ilkerya/Emulator_PCB/Cur_Emul_1.jpg

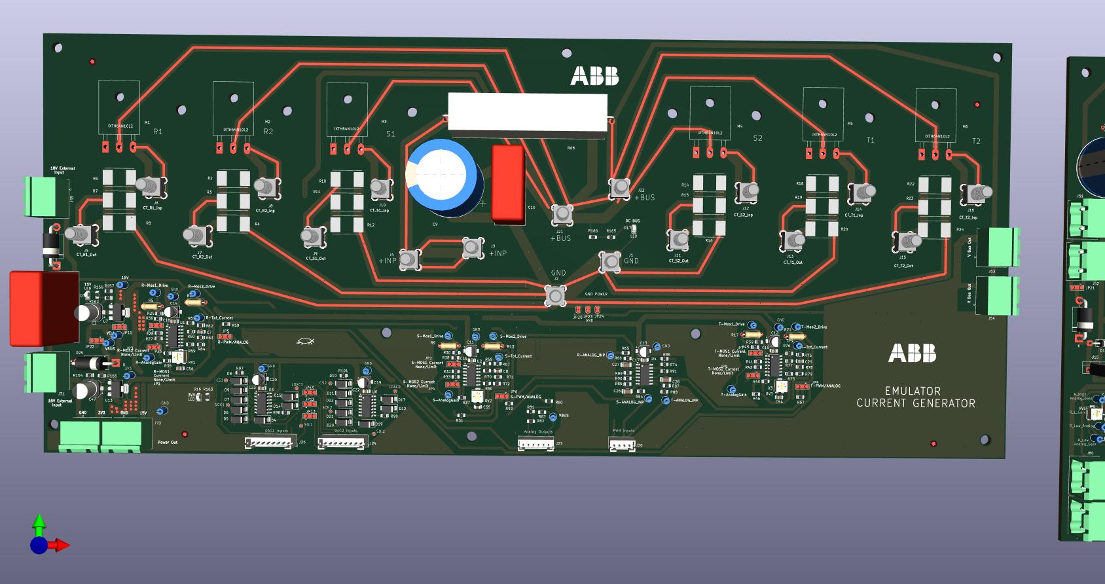
Cur_Emul_1.jpg
