ilkerya/Emulator_PCB/Cur_Emul_4.jpg

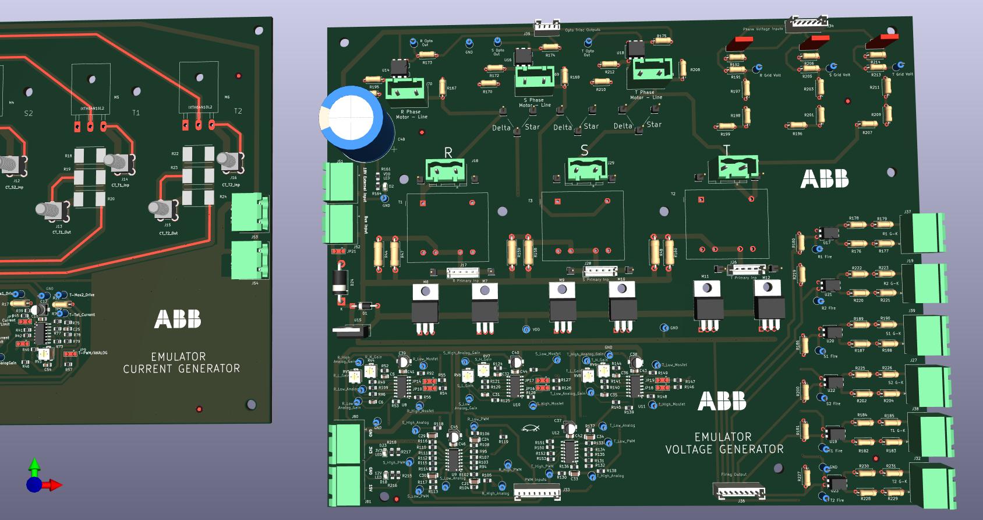
Cur_Emul_4.jpg
