ilkerya/Emulator_PCB/Cur_Emul/GERBER/Cur_Emul_3.jpg

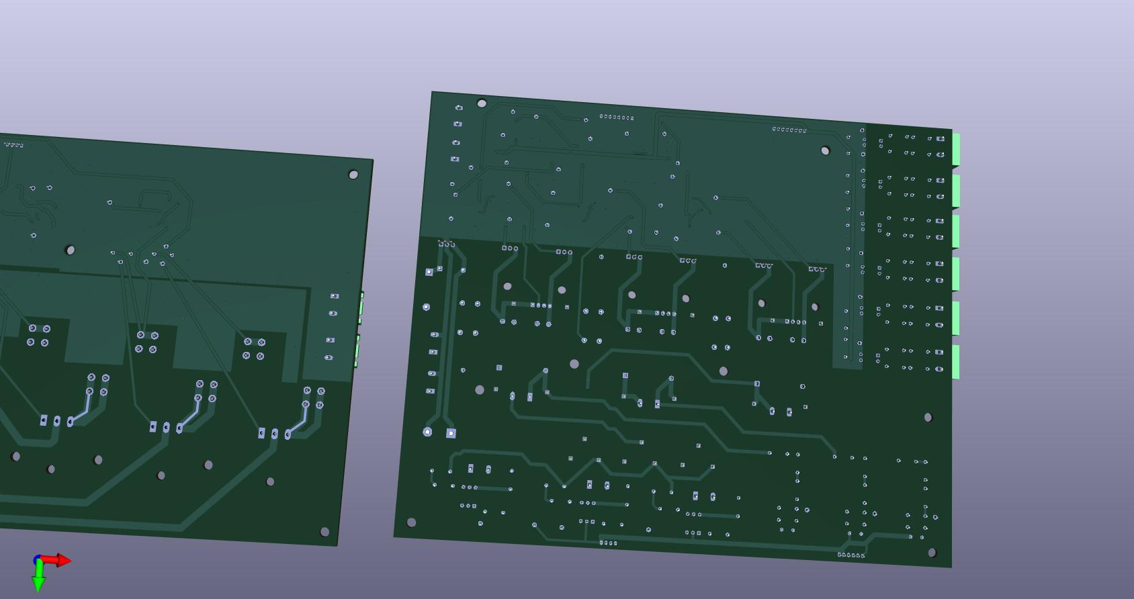
Cur_Emul/GERBER/Cur_Emul_3.jpg
