ilkerya/Emulator_PCB/Cur_Emul/GERBER/Cur_Emul_5.jpg

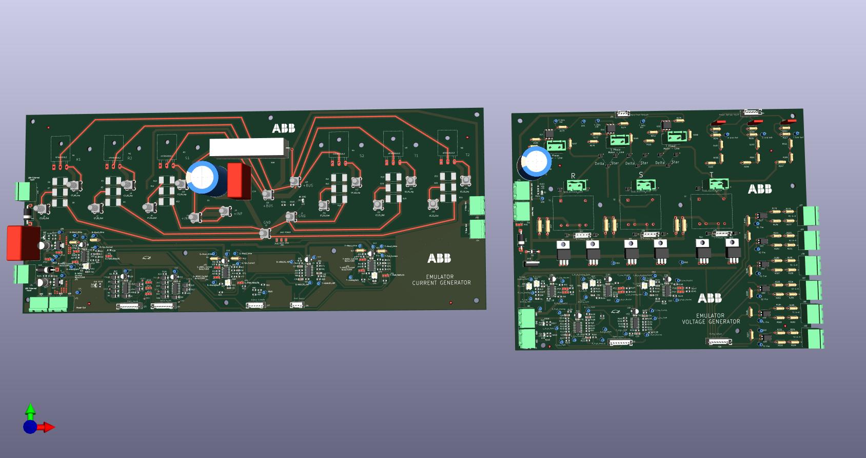
Cur_Emul/GERBER/Cur_Emul_5.jpg
