ilkerya/Emulator_PCB/Cur_Emul/GERBER/Cur_Emul__2.jpg

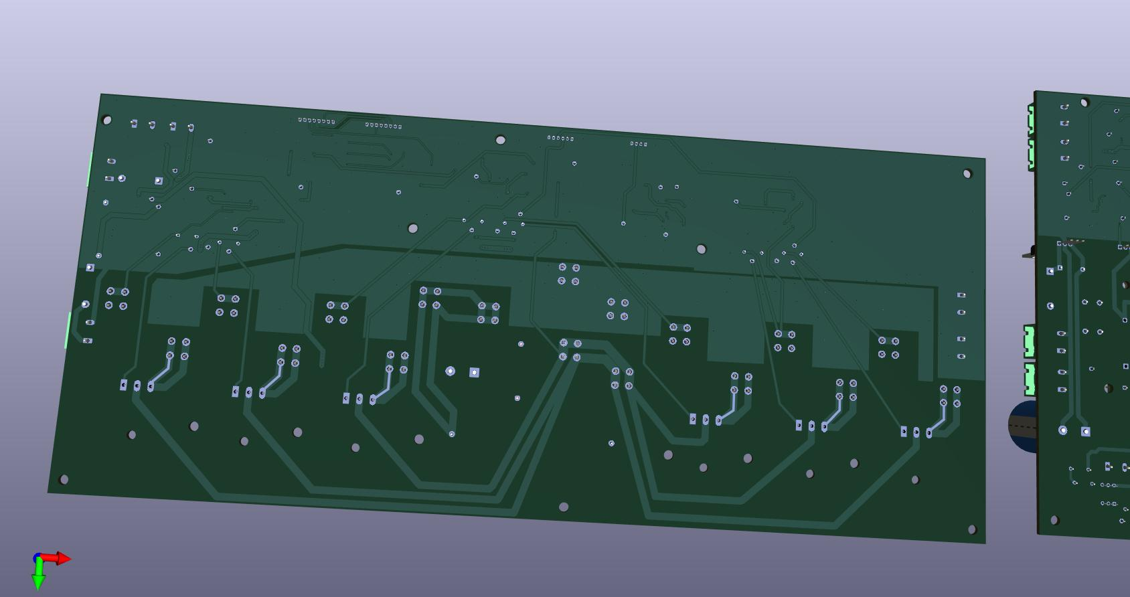
Cur_Emul/GERBER/Cur_Emul__2.jpg
