ilkerya/Emulator_PCB/SoftStart_Connection.jpg

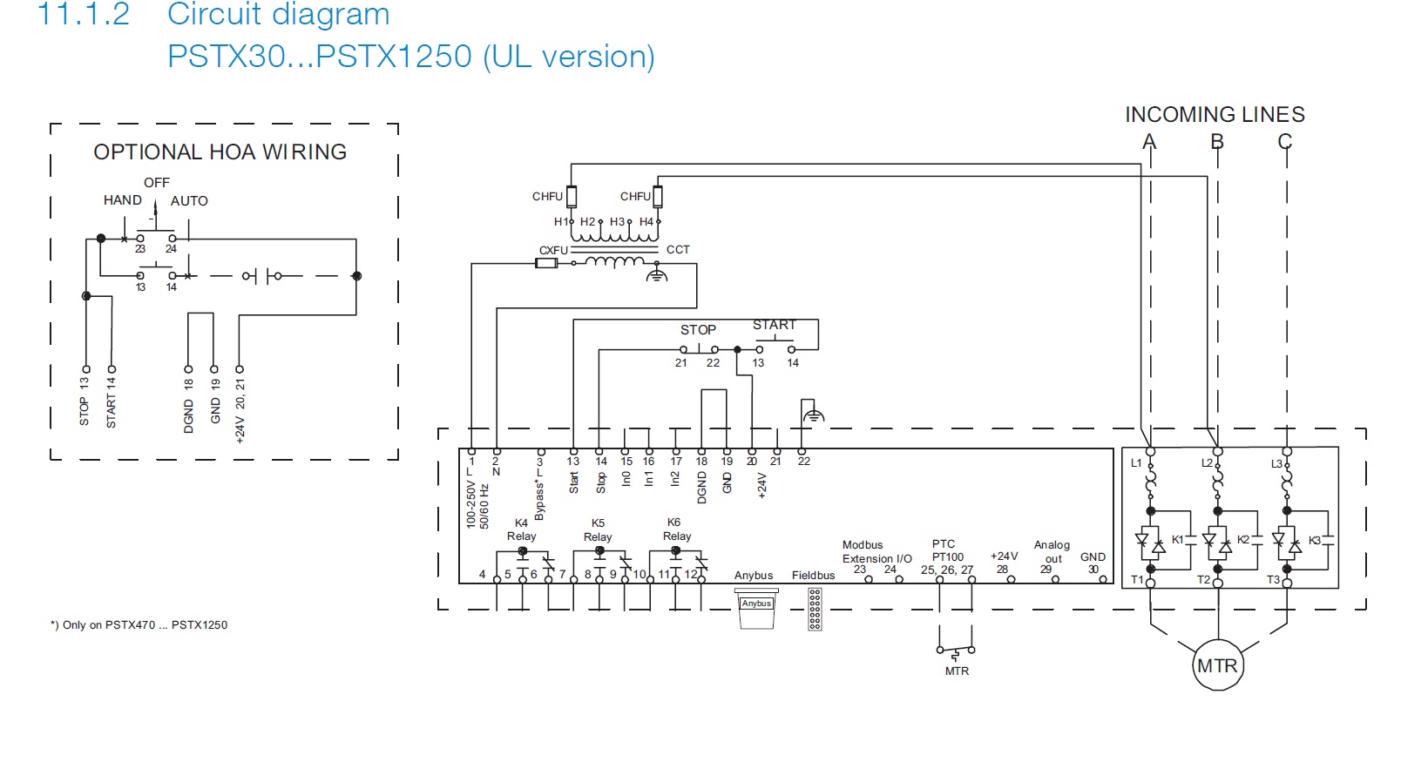
SoftStart_Connection.jpg
