ilkerya/Emulator_PCB/Cur_Emul/Emulator_BOM_V2.xlsx

Sheet: Readme
1 | Check next sheets for the details indicvated as red color
2 | All resistors %5 toleranace unless indicated as %1
3 | All axial tht resistors 0.25W toleranace unless indicated
4 | Do Not Mount ! | Purchase the components, do nat assemble just send with the PCB's
5 | Do Not Buy ! | Neither purchase nor assembly
 | Required Samples
 | At least 15 PCB (2x15)
 | Assembled Samples
 | 10 Samples with full SMD components assembled
 | just 2 samples with the THT components assembled (8 samples with just SMD)

Sheet: Full_BOM
Id | Designator | Footprint | Quantity | Designation | Supplier and ref
1 | U3,U10,U11,U4,U12,U9,U1,U2,U8 | SOIC-14_3.9x8.7mm_P1.27mm | 9 | Opamp_Quad_OPA_4196
2 | R95,R115,R97,R71,R116,R80,R81,R99,R63,R74,R133,R132,R64,R94,R61,R136,R65,R102,R79,R153,R111,R107,R104,R130,R103,R106,R76,R108,R137,R110,R134,R87,R117,R86,R98,R131,R78,R101,R113,R69,R72,R84,R151,R152,R112,R85,R150,R135,R66,R88,R114 | R_0805_2012Metric_Pad1.20x1.40mm_HandSolder | 51 | 10K %1
3 | R204,R231,R178,R228,R221,R222,R183,R226,R188,R190,R225,R189,R182,R179,R202,R229,R177,R220,R185,R176,R230,R187,R223,R184 | R_Axial_DIN0207_L6.3mm_D2.5mm_P7.62mm_Horizontal | 24 | 33K
4 | J60,J65,J40,J42,J64,J59,J41,J67,J56,J62,J61,J48,J45,J63,J46,J66,J47,J43,J57,J58,J44 | PinHeader_1x01_P2.54mm_Vertical | 21 | PinHeader_1x2.54mm
5 | J80,J31,J73,J51,J38,J27,J72,J81,J39,J53,J32,J37,J19,J52,J55,J54 | PhoenixContact_GMSTBA_2,5_2-G_1x02_P7.50mm_Horizontal | 16 | 2x7.50mm_Horizontal_PhoenixContact_GMSTBA
6 | D26,D25,D24 | D_DO-201AD_P15.24mm_Horizontal | 3 | 1N5407
7 | R28,R144,R32,R39,R52,R129,R41,R56,R138,R148,R109,R125,R118,R119,R27,R145,R105,R31,R30,R25,R149,R139,R53,R128,R33,R92,R42,R40,R124,R26 | R_0805_2012Metric_Pad1.20x1.40mm_HandSolder | 30 | 100R %1
8 | C14,C45,C13,C20,C37,C11,C40,C38,C39,C12,C19 | CP_Elec_4x3.9 | 11 | 10uF/50V
9 | J22,J15,J14,J10,J13,J9,J2,J4,J16,J7,J8,J5,J11,J6,J3,J21,J1,J12 | Wuerth_REDCUBE-THR_WP-THRSH_74651175_THR | 18 | Wuerth_REDCUBE-74651175_ScrewTerminal
10 | C42,C5,C23,C54,C6,C44,C55,C32,C36,C31,C16,C46,C22,C17,C18,C35,C56,C7,C15,C25,C8,C41,C43 | C_0805_2012Metric_Pad1.18x1.45mm_HandSolder | 23 | 10nF/50V
11 | M4,M1,M2,M5,M3,M6 | TO-247-3_Horizontal_TabDown | 6 | IXTH64N10L2 |  |  | Do Not Mount !
12 | U5,U6 | SOIC-14_3.9x8.7mm_P1.27mm | 2 | MCP4922-ESL
13 | R163,R216,R91,R161,R218,R90,R164,R215,R217,R166,R89,R165 | R_0805_2012Metric_Pad1.20x1.40mm_HandSolder | 12 | 5K %1
14 | RV2,RV5,RV6,RV1,RV7,RV8,RV3,RV9,RV4 | Potentiometer_Bourns_3314J_Vertical | 9 | 10K_SMD_Pot
15 | TP37,TP34,TP63,TP66,TP5,TP42,TP33,TP13,TP67,TP58,TP76,TP18,TP32,TP51,TP45,TP41,TP56,TP14,TP48,TP1,TP52,TP69,TP77,TP75,TP71,TP28,TP2,TP38,TP3,TP35,TP68,TP10,TP43,TP61,TP17,TP72,TP11,TP55,TP64,TP31,TP74,TP15,TP20,TP6,TP57,TP27,TP70,TP59,TP8,TP7,TP12,TP78,TP50,TP65,TP49,TP4,TP47,TP19,TP16,TP29,TP44,TP46,TP9,TP62,TP60,TP30,TP73,TP36,TP53,TP54 | TestPoint_Loop_D1.80mm_Drill1.0mm_Beaded | 70 | Test_Point_THT_KeyStone
16 | R77,R49,R73,R121,R120,R59,R60,R140,R141,R50,R70,R96 | R_0805_2012Metric_Pad1.20x1.40mm_HandSolder | 12 | 3K3 %1
17 | U22,U21,U23,U19,U20,U17 | DIP-4_W7.62mm | 6 | SFH620A-2
18 | C26,C29,C24,C27,C30,C34,C33,C28,C21 | C_1206_3216Metric_Pad1.33x1.80mm_HandSolder | 9 | 1uF/50V
19 | R197,R201,R196,R211,R203,R207,R198,R199,R209 | R_Axial_DIN0207_L6.3mm_D2.5mm_P7.62mm_Horizontal | 9 | 470K
20 | D8,D10,D4,D6,D15,D20,D7,D22,D5,D13,D19,D14,D9,D21,D12,D11 | D_SMA | 16 | US2AA
21 | J68,J70,J29,J69,J30,J18 | PhoenixContact_GMSTBVA_2,5_2-G_1x02_P7.50mm_Vertical | 6 | 2x7.50mm_Vertical_PhoenixContact_GMSTB
22 | R17,R13,R1,R5,R9,R21 | R_Axial_DIN0207_L6.3mm_D2.5mm_P7.62mm_Horizontal | 6 | 330K
23 | R192,R206,R173,R174,R175,R214 | R_Axial_DIN0207_L6.3mm_D2.5mm_P7.62mm_Horizontal | 6 | 1K
24 | R35,R146,R127,R46,R37,R126,R54,R38,R55,R45,R36,R147 | R_0805_2012Metric_Pad1.20x1.40mm_HandSolder | 12 | 10R
25 | R57,R162,R62,R75,R82,R93,R58,R67,R83 | R_0805_2012Metric_Pad1.20x1.40mm_HandSolder | 9 | 1K %1
26 | R169,R208,R167 | R_Axial_DIN0207_L6.3mm_D2.5mm_P7.62mm_Horizontal | 3 | 100R
27 | D1 | D_DO-41_SOD81_P10.16mm_Horizontal | 1 | 1N4007
28 | R210,R212,R172,R195,R168,R170 | R_Axial_DIN0207_L6.3mm_D2.5mm_P7.62mm_Horizontal | 6 | 100K
29 | TP23,TP40,TP24,TP39,TP21,TP26,TP22,TP25 | TestPoint_Pad_D1.0mm | 8 | Test_Pad_Not_A_Component
30 | M7,M10,M12,M9,M8,M11 | TO-220-3_Horizontal_TabDown | 6 | IRF530 |  | Do Not Mount !
31 | R157 | R_0805_2012Metric_Pad1.20x1.40mm_HandSolder | 1 | 750R / %1
32 | D23,D17,D3,D16,D2,D18 | LED_0805_2012Metric_Pad1.15x1.40mm_HandSolder | 6 | LED
33 | R11,R19,R18,R10,R2,R7,R3,R23,R12,R20,R14,R24,R15,R4,R22,R6,R16,R8 | R_Shunt_Vishay_WSR2_WSR3 | 18 | 10mOhm_Vishay_WSR3_Shunt |  | Do Not Mount !
34 | R200,R181,R219,R205,R180,R186,R227,R191,R213 | R_Axial_DIN0207_L6.3mm_D2.5mm_P7.62mm_Horizontal | 9 | 10K
35 | U13,U7 | SOT-223-3_TabPin2 | 2 | LM317_SOT-223
36 | C10,C49 | C_Rect_L28.0mm_W12.0mm_P22.50mm_MKS4 | 2 | 1uF/50V MKT |  | Do Not Mount ! |  | Do Not Buy !
37 | U14,U16,U18 | DIP-6_W7.62mm | 3 | MOC3023M
38 | J36,J25,J24,J33 | JST_PH_B8B-PH-K_1x08_P2.00mm_Vertical | 4 | Conn_01x08_Pin_JST_2.0mm
39 | R154 | R_0805_2012Metric_Pad1.20x1.40mm_HandSolder | 1 | 1K22 / %1
40 | R155 | R_0805_2012Metric_Pad1.20x1.40mm_HandSolder | 1 | 110R / %1
41 | J35,J20 | JST_PH_B4B-PH-K_1x04_P2.00mm_Vertical | 2 | Conn_01x04_Pin_JST_2.0mm
42 | C50,C52,C51 | C_Rect_L7.0mm_W2.0mm_P5.00mm | 3 | 100nF/50V
43 | J34,J23 | JST_PH_B6B-PH-K_1x06_P2.00mm_Vertical | 2 | Conn_01x06_Pin_JST_2.0mm
44 | T1,T3,T2 | Transformer_Myrra_EI30-5_44000_Horizontal | 3 | Transformer_1P_2S |  | Do Not Mount !
45 | R158,R44,R160,R48,R47,R159 | R_Axial_DIN0411_L9.9mm_D3.6mm_P12.70mm_Horizontal | 6 | 4R7/2W
46 | J17,J26,J28 | JST_EH_B4B-EH-A_1x04_P2.50mm_Vertical | 3 | Conn_01x04_Pin_JST_2.5mm
47 | U15 | TO-220-3_Vertical | 1 | LM7812_TO220
48 | C9 | CP_Radial_D26.0mm_P10.00mm_SnapIn | 1 | 300uF/50V |  | Do Not Mount ! |  | Do Not Buy !
49 | C48 | CP_Radial_D24.0mm_P10.00mm_SnapIn | 1 | 1000uF/50V |  | Do Not Mount ! |  | Do Not Buy !
50 | R156 | R_0805_2012Metric_Pad1.20x1.40mm_HandSolder | 1 | 450R / %1
51 | C47,C3 | CP_Elec_6.3x7.7 | 2 | 100uF/50V
52 | R68 | R_Axial_Power_L60.0mm_W14.0mm_P66.04mm | 1 | 1R/100W |  | Do Not Mount ! |  | Do Not Buy !

Sheet: Actives
 |  | Package | Count | Part No | Purchase Info
1 | U22,U21,U23,U19,U20,U17 | DIP-4_W7.62mm | 6 | SFH620A-2 | sfh620a.pdf (https://www.vishay.com/docs/83675/sfh620a.pdf)
2 | U5,U6 | SOIC-14_3.9x8.7mm_P1.27mm | 2 | MCP4922-ESL | MCP4922-ESL (https://www.digikey.se/sv/products/detail/microchip-technology/MCP4922-E-SL/716258)
3 | U3,U10,U11,U4,U12,U9,U1,U2,U8 | SOIC-14_3.9x8.7mm_P1.27mm | 9 | OPA4196 | 4196 (https://www.digikey.se/en/products/detail/texas-instruments/OPA4196IDR/7604402)
4 | U13,U7 | SOT-223-3_TabPin2 | 2 | LM317 | LM317MDCYR (https://www.digikey.se/en/products/detail/texas-instruments/LM317MDCYR/454187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)
5 | U14,U16,U18 | DIP-6_W7.62mm | 3 | MOC3023M | MOC3023M (https://www.digikey.se/sv/products/detail/onsemi/MOC3023M/284886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)
6 | U15 | TO-220-3_Vertical | 1 | LM7812
7 | M4,M1,M2,M5,M3,M6 | TO-247-3_Horizontal_TabDown | 6 | IXTH64N10L2 | IXTH64N10L2 IXYS | Discrete Semiconductor Products | DigiKey (https://www.digikey.se/en/products/detail/ixys/IXTH64N10L2/5810059) |  | Do Not Mount
8 | M7,M10,M12,M9,M8,M11 | TO-220-3_Horizontal_TabDown | 6 | IRF530 | IRF530PBF Vishay Siliconix | Diskreta halvledarprodukter | DigiKey (https://www.digikey.se/sv/products/detail/vishay-siliconix/IRF530PBF/811781) |  | Do Not Mount
9 | D23,D17,D3,D16,D2,D18 | LED_0805_2012Metric_Pad1.15x1.40mm_HandSolder | 6 | Green LED
10 | D26,D25,D24 | D_DO-201AD_P15.24mm_Horizontal | 3 | 1N5407 | 1n5400.pdf (https://www.vishay.com/docs/88516/1n5400.pdf)
11 | D8,D10,D4,D6,D15,D20,D7,D22,D5,D13,D19,D14,D9,D21,D12,D11 | D_SMA | 16 | US2AA | US2AA (https://www.onsemi.com/pdf/datasheet/us2aa-d.pdf) | US2MA onsemi | Discrete Semiconductor Products | DigiKey (https://www.digikey.se/en/products/detail/onsemi/US2MA/5844490?msockid=3cb83edbc5ab62f42d3f2b92c4fc63d6)
12 | D1 | D_DO-41_SOD81_P10.16mm_Horizontal | 1 | 1N4007

Sheet: Connector_Pin
 | ON PCB |  | Count per PCB pair |  |  |  |  |  | Item Number
 | 7.5 mm Pitch Connectors form Phoenix Contact |  |  |  |  |  |  | Purchase | Phoenix Contact
1 | J70,J69,J68,J29,J30,J18 | PhoenixContact_GMSTBVA_2,5_2-G_1x02_P7.50mm_Vertical | 6 | Conn_01x02_Pin |  | Vertical | Female | 1. Priority (https://www.mouser.se/ProductDetail/Phoenix-Contact/1766660?qs=VKrXD49J9ErTDZSltEsgTQ%3D%3D) | 1766660
 |  |  |  |  |  |  |  | 2.Priority (https://www.mouser.se/ProductDetail/Phoenix-Contact/1766453?qs=s6DiDDoRpTbteEwY3ZEIDg%3D%3D) | 1766453
2 | J31,J51,J38,J27,J39,J53,J32,J37,J19,J52,J55,J54 | PhoenixContact_GMSTBA_2,5_2-G_1x02_P7.50mm_Horizontal | 16 | Conn_01x02_Pin |  | Horizontal | Female | 1.Priority (https://www.digikey.se/en/products/detail/phoenix-contact/1766343/348818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) | 1766343
 | J72,J73,J80,J81 |  |  |  |  |  |  | 2.Priority (https://www.mouser.se/ProductDetail/Phoenix-Contact/1766013?qs=s6DiDDoRpTZAMqnWKfx7Zg%3D%3D) | 1766013
 | High Current Terminals from Wurth
3 | J22,J15,J14,J10,J13,J9,J2,J4,J16,J7,J8,J5,J11,J6,J3,J21,J1,J12 | Wuerth_REDCUBE-THR_WP-THRSH_74651175_THR | 18 | Screw_Terminal_01x01 |  |  | 74651175R (https://www.digikey.co.uk/en/products/detail/w%C3%BCrth-elektronik/74651175R/6644002) | 74651175 Datasheet WP-THRSH REDCUBE (https://www.we-online.com/components/products/datasheet/74651175.pdf)
 | Test Pins
4 | TP37,TP34,TP63,TP66,TP5,TP42,TP33,TP13,TP67,TP58,TP76,TP18,TP32,TP51,TP45,TP41,TP56,TP14,TP48,TP1,TP52,TP69,TP77,TP75,TP71,TP28,TP2,TP38,TP3,TP35,TP68,TP10,TP43,TP61,TP17,TP72,TP11,TP55,TP64,TP31,TP74,TP15,TP20,TP6,TP57,TP27,TP70,TP59,TP8,TP7,TP12,TP78,TP50,TP65,TP49,TP4,TP47,TP19,TP16,TP29,TP44,TP46,TP9,TP62,TP60,TP30,TP73,TP36,TP53,TP54 | TestPoint_Loop_D1.80mm_Drill1.0mm_Beaded | 70 | TestPoint_Alt |  |  | 5117 Keystone Electronics | Test and Measurement | DigiKey (https://www.digikey.se/en/products/detail/keystone-electronics/5117/2170320)
 | Pin terminals Do Not Mount!
5 | J60,J65,J40,J42,J64,J59,J41,J67,J56,J62,J61,J48,J45,J63,J46,J66,J47,J43,J57,J58,J46 | PinHeader_1x01_P2.54mm_Vertical | 23 | Conn_01x01_Pin |  |  | 61300411121 Würth Elektronik | Kontaktdon | DigiKey (https://www.digikey.se/sv/products/detail/w-rth-elektronik/61300411121/4846827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)
 | 2.00 - 2.5 mm pitch Signal Connectors JST |  |  |  |  | RS
6 | J36,J25,J24,J33 | JST_PH_B8B-PH-K_1x08_P2.00mm_Vertical | 4 | Conn_01x08_Pin |  |  | 5128658P (https://se.rs-online.com/web/p/pcb-headers/5128658P)
7 | J35,J20 | JST_PH_B4B-PH-K_1x04_P2.00mm_Vertical | 2 | Conn_01x04_Pin |  |  | 1724893 (https://se.rs-online.com/web/p/pcb-headers/1724893)
8 | J34,J23 | JST_PH_B6B-PH-K_1x06_P2.00mm_Vertical | 2 | Conn_01x06_Pin |  |  | 1724942 (https://se.rs-online.com/web/p/pcb-headers/1724942)
9 | J17,J26,J28 | JST_EH_B4B-EH-A_1x04_P2.50mm_Vertical | 3 | Conn_01x04_Pin |  |  | 5151406 (https://se.rs-online.com/web/p/pcb-headers/5151406)
 | MATING Cable Side Not to be Mounted !
10 | Housing - Cable Part Mating for Phoenix Contact |  | 22 | 1766880 (https://eu.mouser.com/ProductDetail/Phoenix-Contact/1766013?qs=s6DiDDoRpTZAMqnWKfx7Zg%3D%3D) | 1766880
 | HOUSING -non PCB -Mating for JST for 2.00 - 2.50 mm Connectors |  | 25 | https://eu.mouser.com/ProductDetail/Phoenix-Contact/1766880?qs=CXo1rOUe%2FWv6HeuUWYkLcg%3D%3D
11 | 2mm 4 row |  | 2 | https://se.rs-online.com/web/p/wire-housings-plugs/4766782
12 | 2mm 6 row |  | 2 | https://se.rs-online.com/web/p/wire-housings-plugs/4766805P
13 | 2mm 8 row |  | 4 | https://se.rs-online.com/web/p/wire-housings-plugs/4766827
14 | 2,5 mm 4 row |  | 3 | https://se.rs-online.com/web/p/wire-housings-plugs/3116221

Sheet: Transformer&Other
 |  |  | Count
47 | T1,T3,T2 | Transformer_Myrra_EI30-5_44000_Horizontal | 3 | Transformer_1P_2S | Do Not Mount! | Transformer | BV EI 304 2047 | Hahn PCB-transformator, 230 VAC, 2x 12 VAC, 108mA, 2.6VA | Elfa Distrelec Sverige (https://www.elfa.se/sv/pcb-transformator-230-vac-2x-12-vac-108ma-6va-hahn-bv-ei-304-2047/p/30294632?pos=5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)
34 | R11,R19,R18,R10,R2,R7,R3,R23,R12,R20,R14,R24,R15,R4,R22,R6,R16,R8 | R_Shunt_Vishay_WSR2_WSR3 | 18 | 10mR | Do Not Mount! | Shunt Resistor | WSR3R0100FEA Vishay Dale | Resistors | DigiKey (https://www.digikey.se/en/products/detail/vishay-dale/WSR3R0100FEA/712630)
15 | RV2,RV5,RV6,RV1,RV7,RV8,RV3,RV9,RV4 | Potentiometer_Bourns_3314J_Vertical | 9 | 10K |  | SMD Potentiometer | 3314J-1-103E Bourns Inc. | Potentiometers, Variable Resistors | DigiKey (https://www.digikey.se/en/products/detail/bourns-inc/3314J-1-103E/86580)
