ilkerya/Emulator_PCB/Cur_Emul/Cur_Emul.step

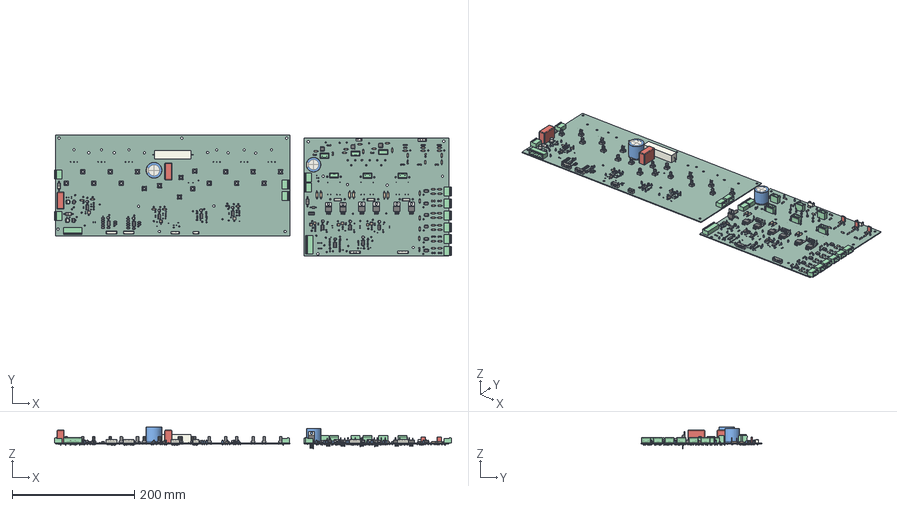
[picture p7: CAD file, 2025-10-06]
Cur_Emul/Cur_Emul.step
650.7 x 199.1 x 35.8 mm
R_0805_2012Metric x 130
R_Axial_DIN0207_L6.3mm_D2.5mm_P7.62mm_Horizontal x 63
PinHeader_1x01_P2.54mm_Vertical x 21
D_DO-201AD_P15.24mm_Horizontal x 3
CP_Elec_4x3.9 x 11
PhoenixContact_GMSTBA_2,5_2-G_1x02_P7.50mm_Horizontal x 12
Wuerth_REDCUBE-THR_WP-THRSH_74651175_THR x 18
C_0805_2012Metric x 23
SOIC-14_3.9x8.7mm_P1.27mm x 11
Potentiometer_Bourns_3314J_Vertical x 9
TestPoint_Loop_D1.80mm_Drill1.0mm_Beaded x 70
DIP-4_W7.62mm x 6
C_1206_3216Metric x 9
D_SMA x 16
PhoenixContact_GMSTBVA_2,5_2-G_1x02_P7.50mm_Vertical x 6
D_DO-41_SOD81_P10.16mm_Horizontal
TO-220-3_Horizontal_TabDown x 6
LED_0805_2012Metric x 6
PhoenixContact_GMSTBA_2,5_4-G-7,62_1x04_P7.62mm_Horizontal x 2
SOT-223 x 2
C_Rect_L28.0mm_W12.0mm_P22.50mm_MKS4 x 2
DIP-6_W7.62mm x 3
JST_PH_B8B-PH-K_1x08_P2.00mm_Vertical x 4
JST_PH_B4B-PH-K_1x04_P2.00mm_Vertical x 2
C_Rect_L7.0mm_W2.0mm_P5.00mm x 3
JST_PH_B6B-PH-K_1x06_P2.00mm_Vertical x 2
R_Axial_DIN0411_L9.9mm_D3.6mm_P12.70mm_Horizontal x 6
JST_EH_B4B-EH-A_1x04_P2.50mm_Vertical x 3
TO-220-3_Vertical
CP_Radial_D26.0mm_P10.00mm_SnapIn
CP_Radial_D24.0mm_P10.00mm_SnapIn
CP_Elec_6.3x7.7 x 2
R_Axial_Power_L60.0mm_W14.0mm_P66.04mm
Cur_Emul_PCB_1
Cur_Emul_PCB_2
