ilkerya/Emulator_PCB/Cur_Emul.pdf

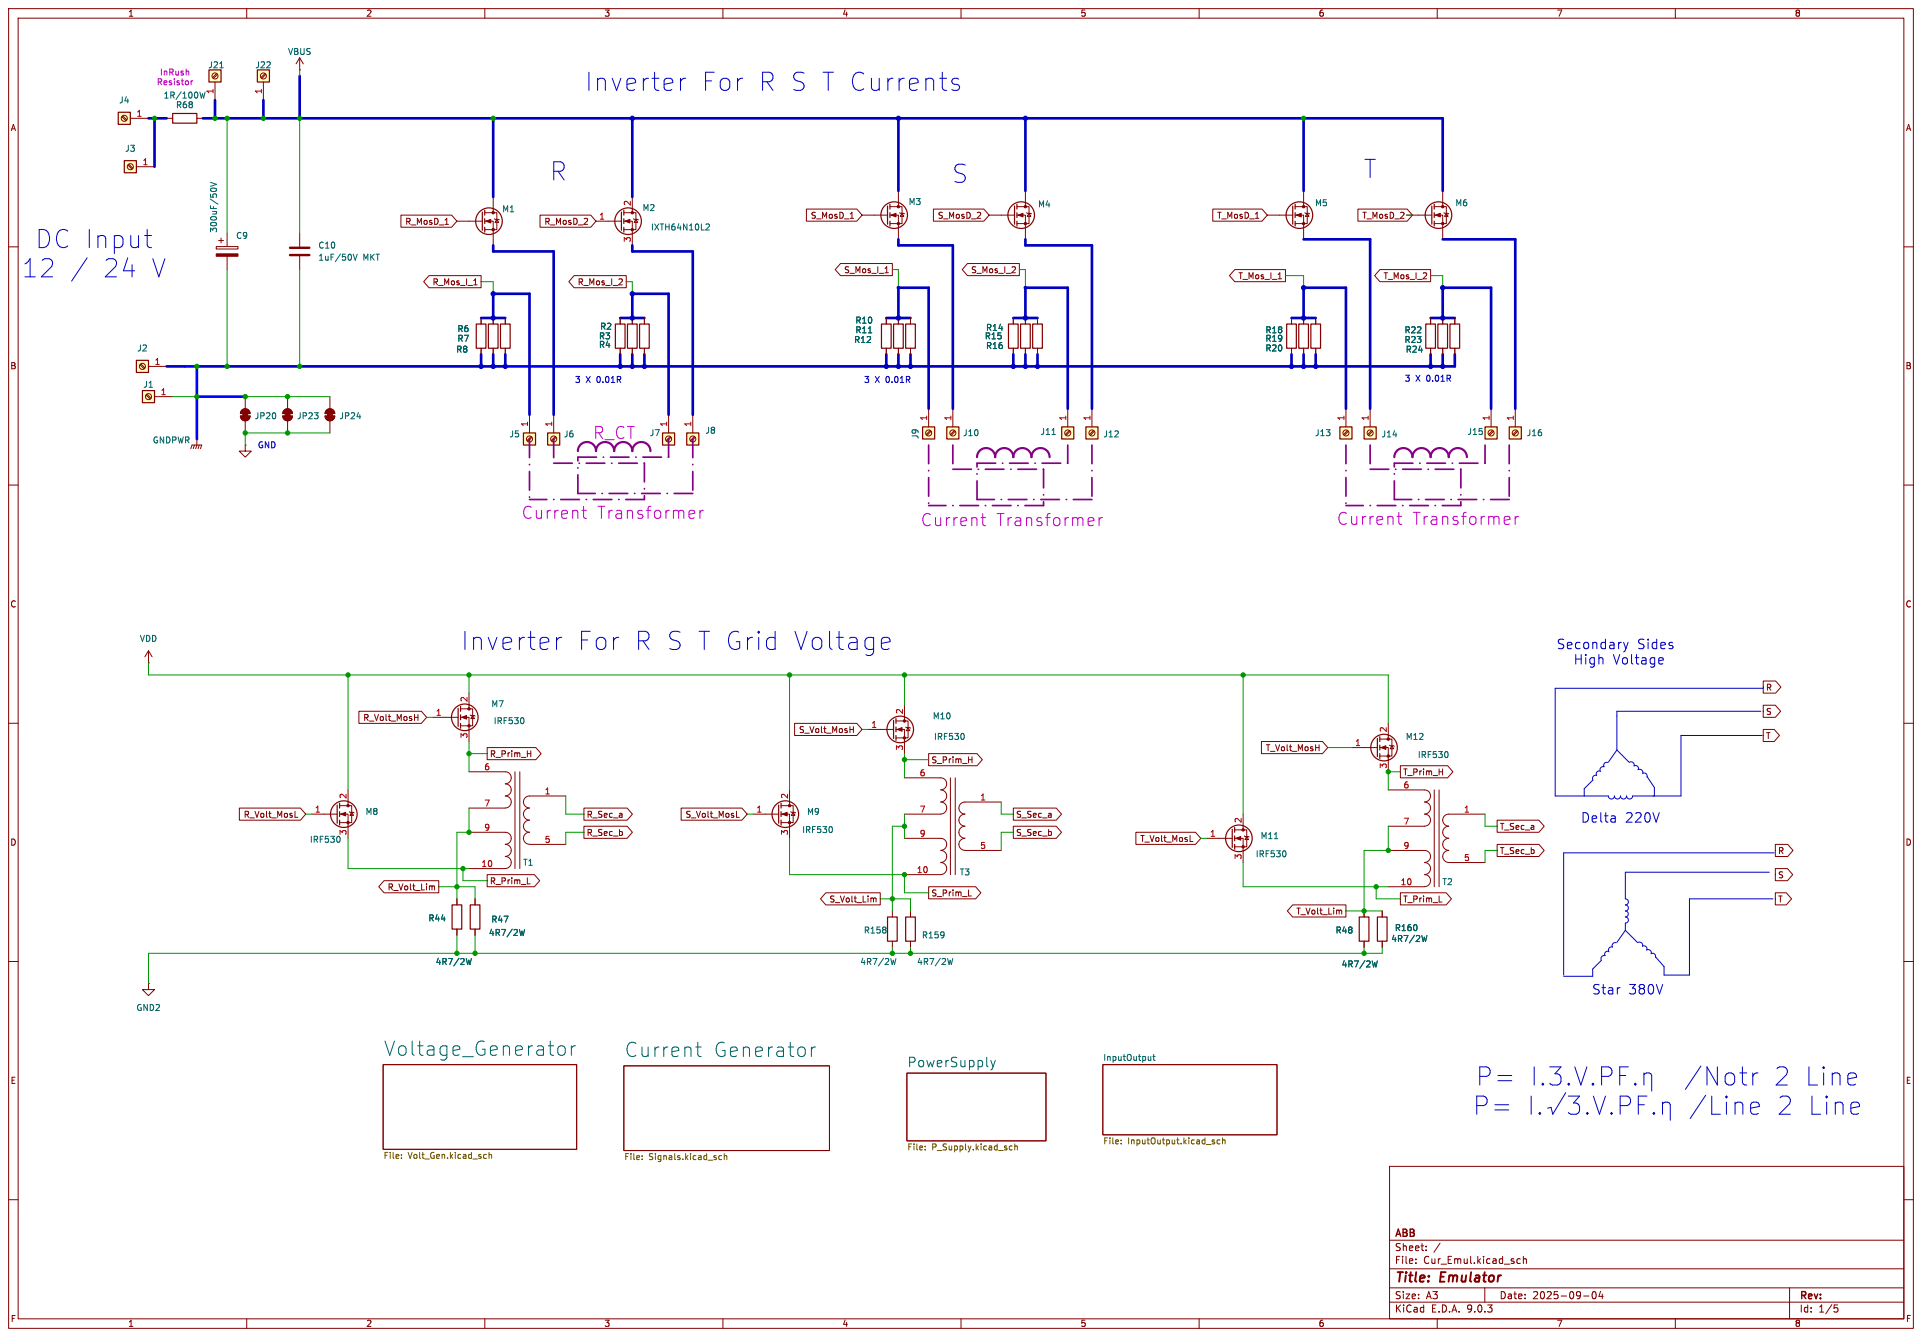
[picture p8: page 1]

Id: 1/5 Title: Emulator File: Cur_Emul.kicad_sch Sheet: / ABB PowerSupply

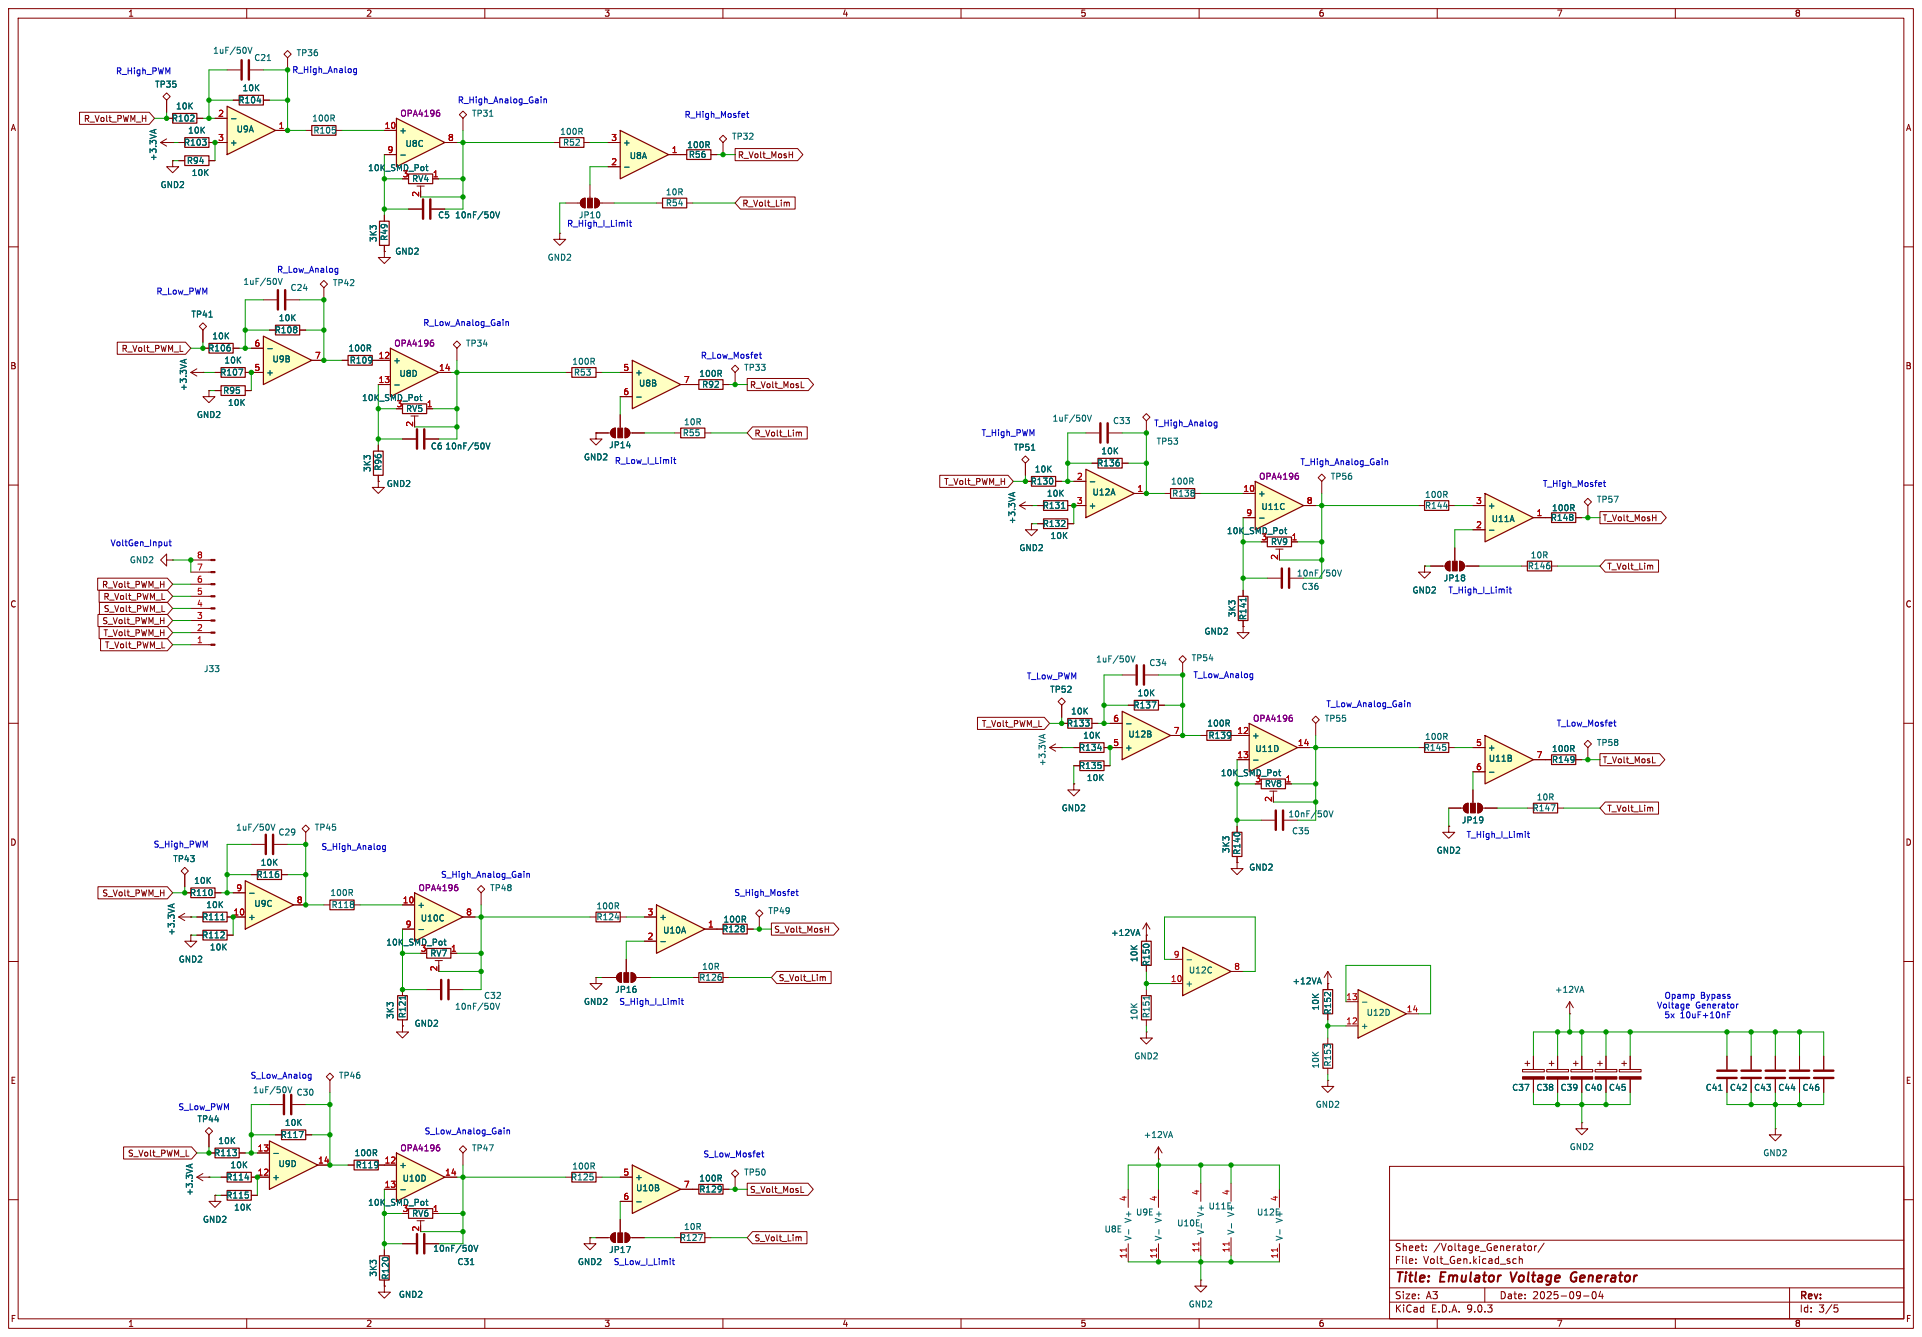
[picture p9: page 2]

Id: 3/5 Title: Emulator Voltage Generator File: Volt_Gen.kicad_sch Sheet: /Voltage_Generator/ +3.3VA

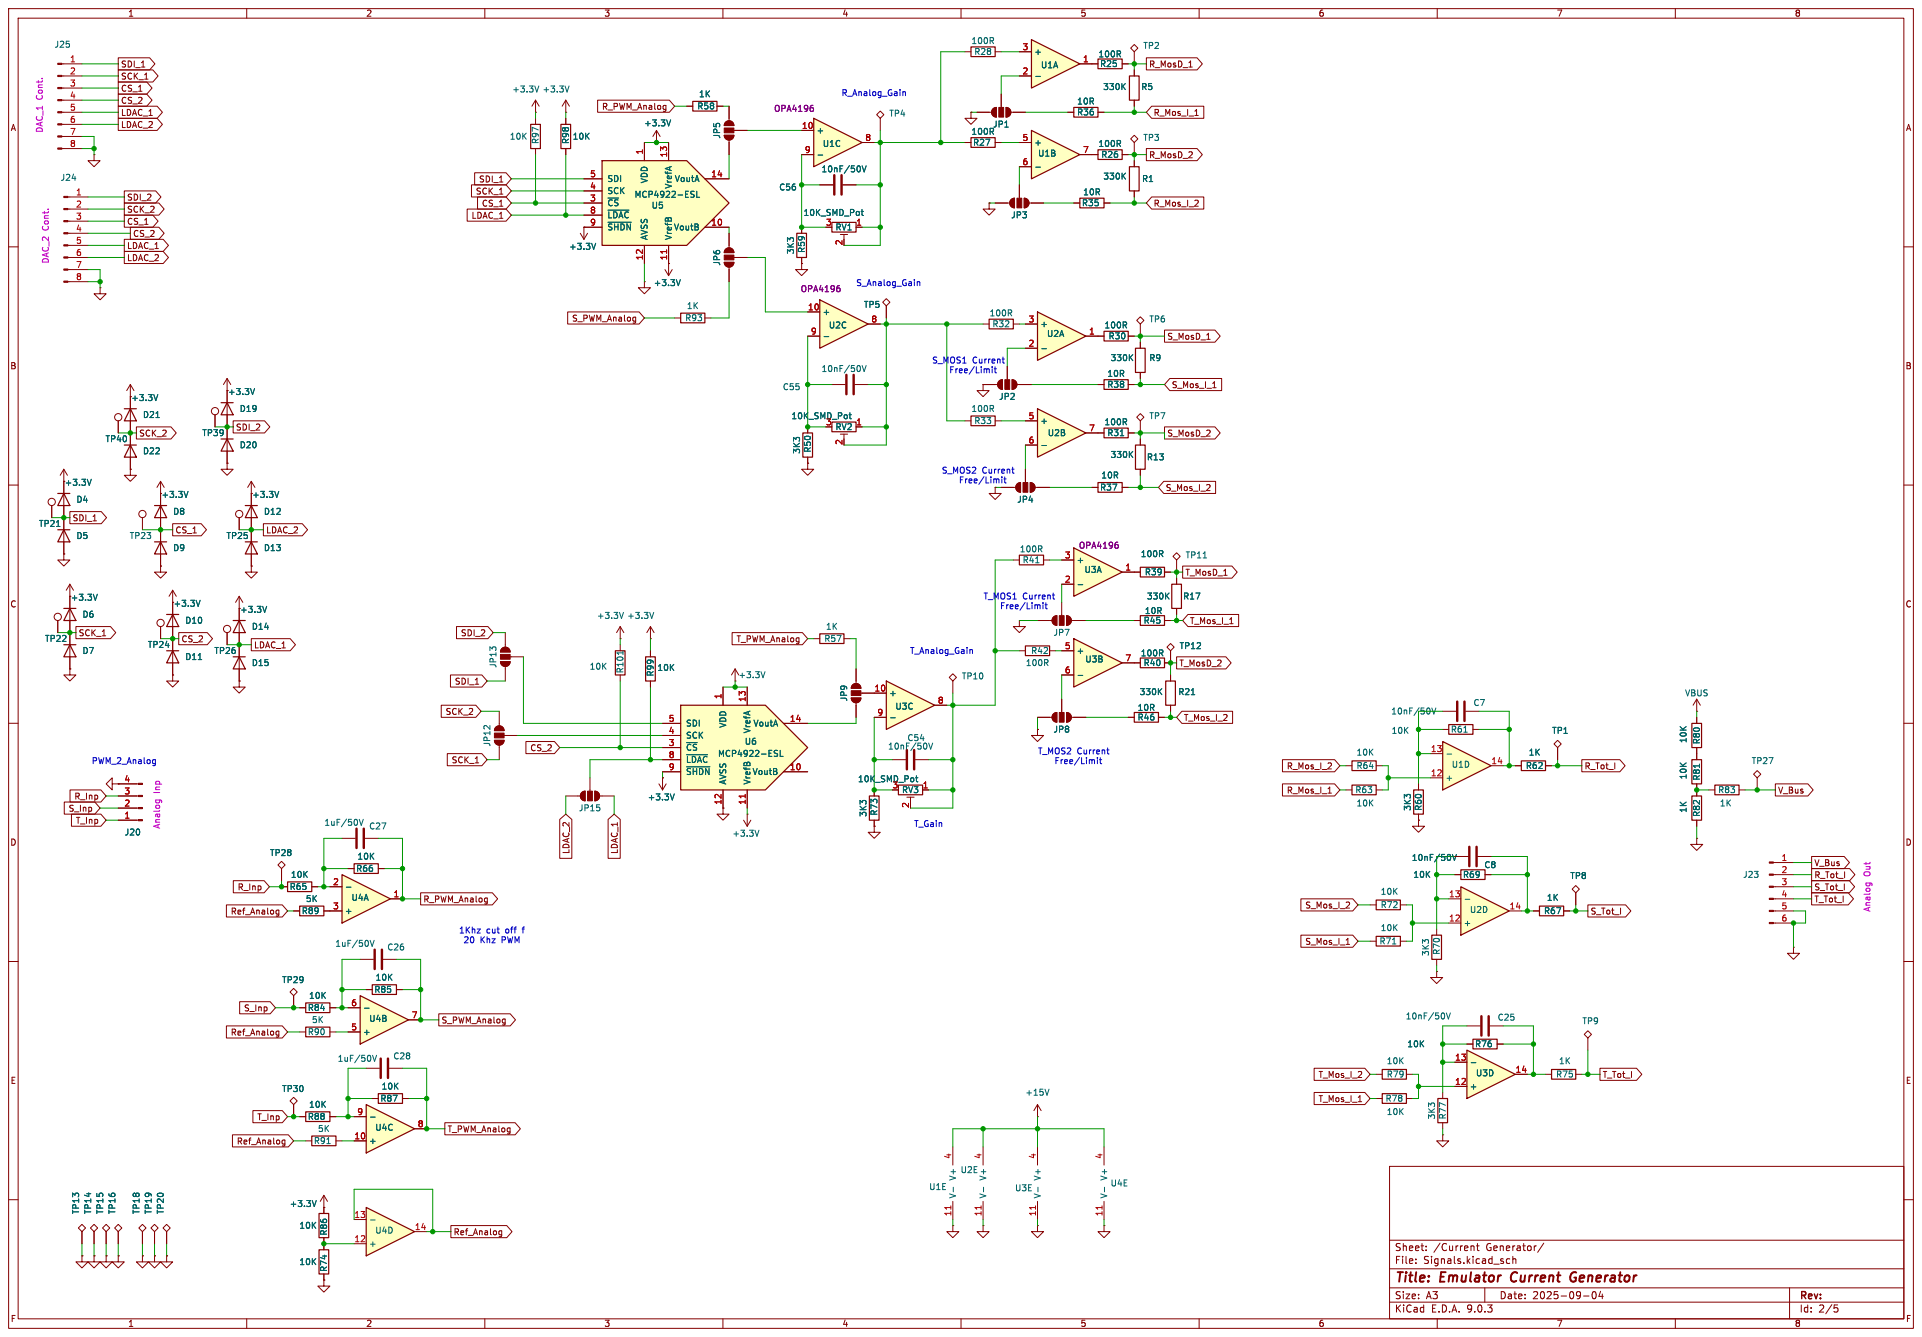
[picture p10: page 3]

1 AVSS 12 VrefA 13 VrefB 11 VoutA 14 VoutB 10 U5 MCP4922-ESL +3.3V JP6 R93

1 AVSS 12 VrefA 13 VrefB 11 VoutA 14 VoutB 10 +3.3V JP6 +3.3V 3K3 R50 RV2

1 AVSS 12 VrefA 13 VrefB 11 VoutA 14 VoutB 10 U6 MCP4922-ESL +3.3V JP9 R57

1 AVSS 12 VrefA 13 VrefB 11 VoutA 14 VoutB 10 TP8 R62

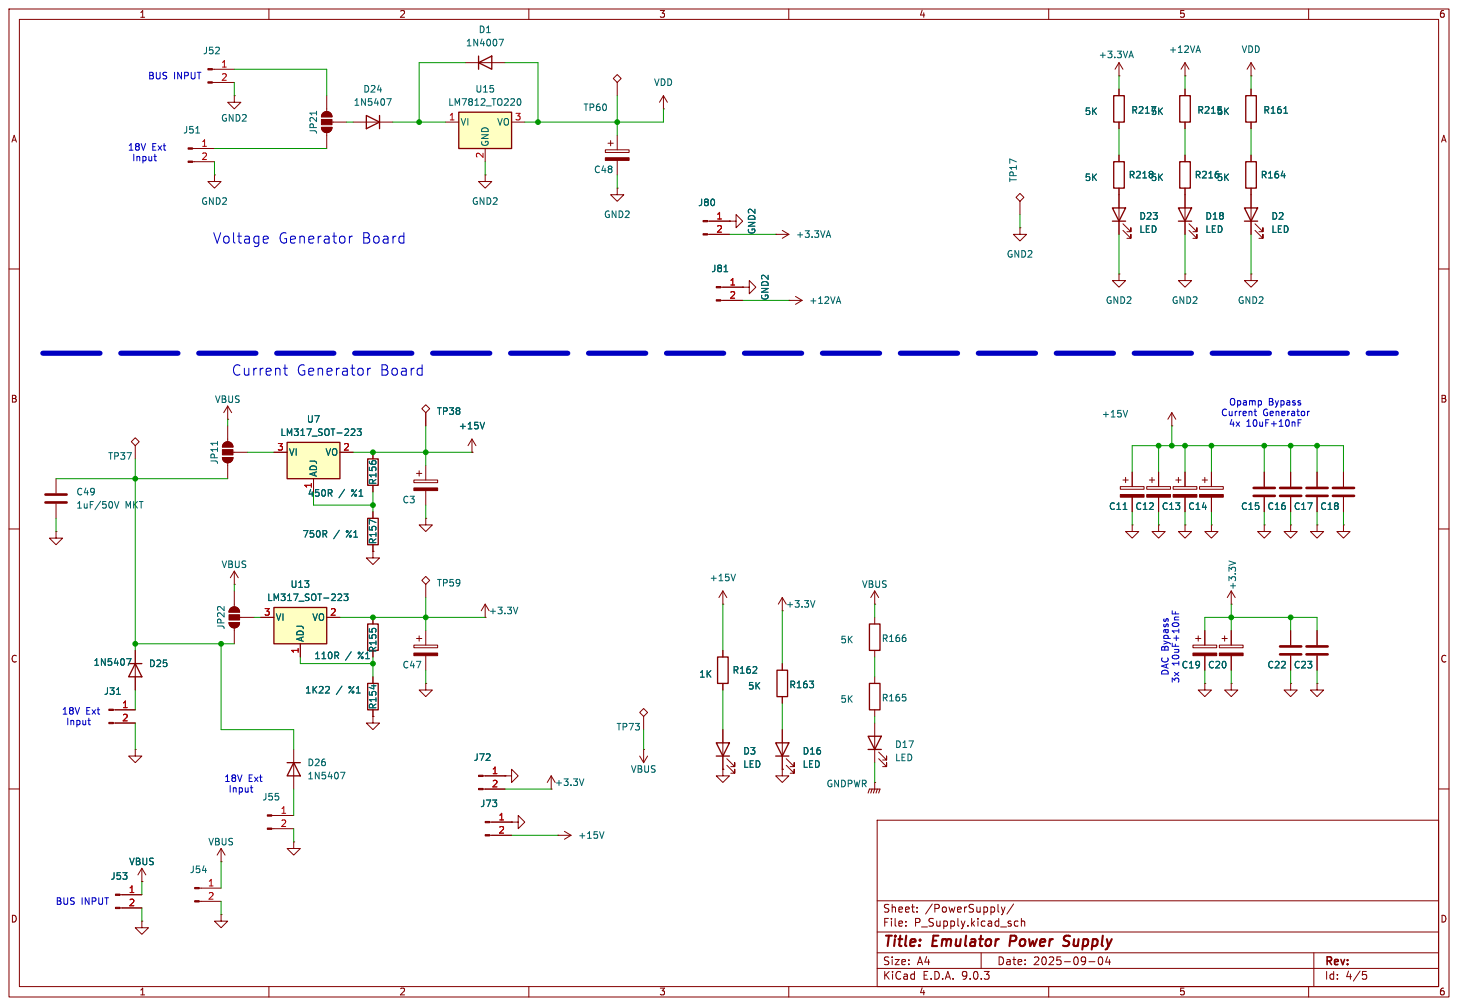
[picture p11: page 4]

Id: 4/5 Title: Emulator Power Supply

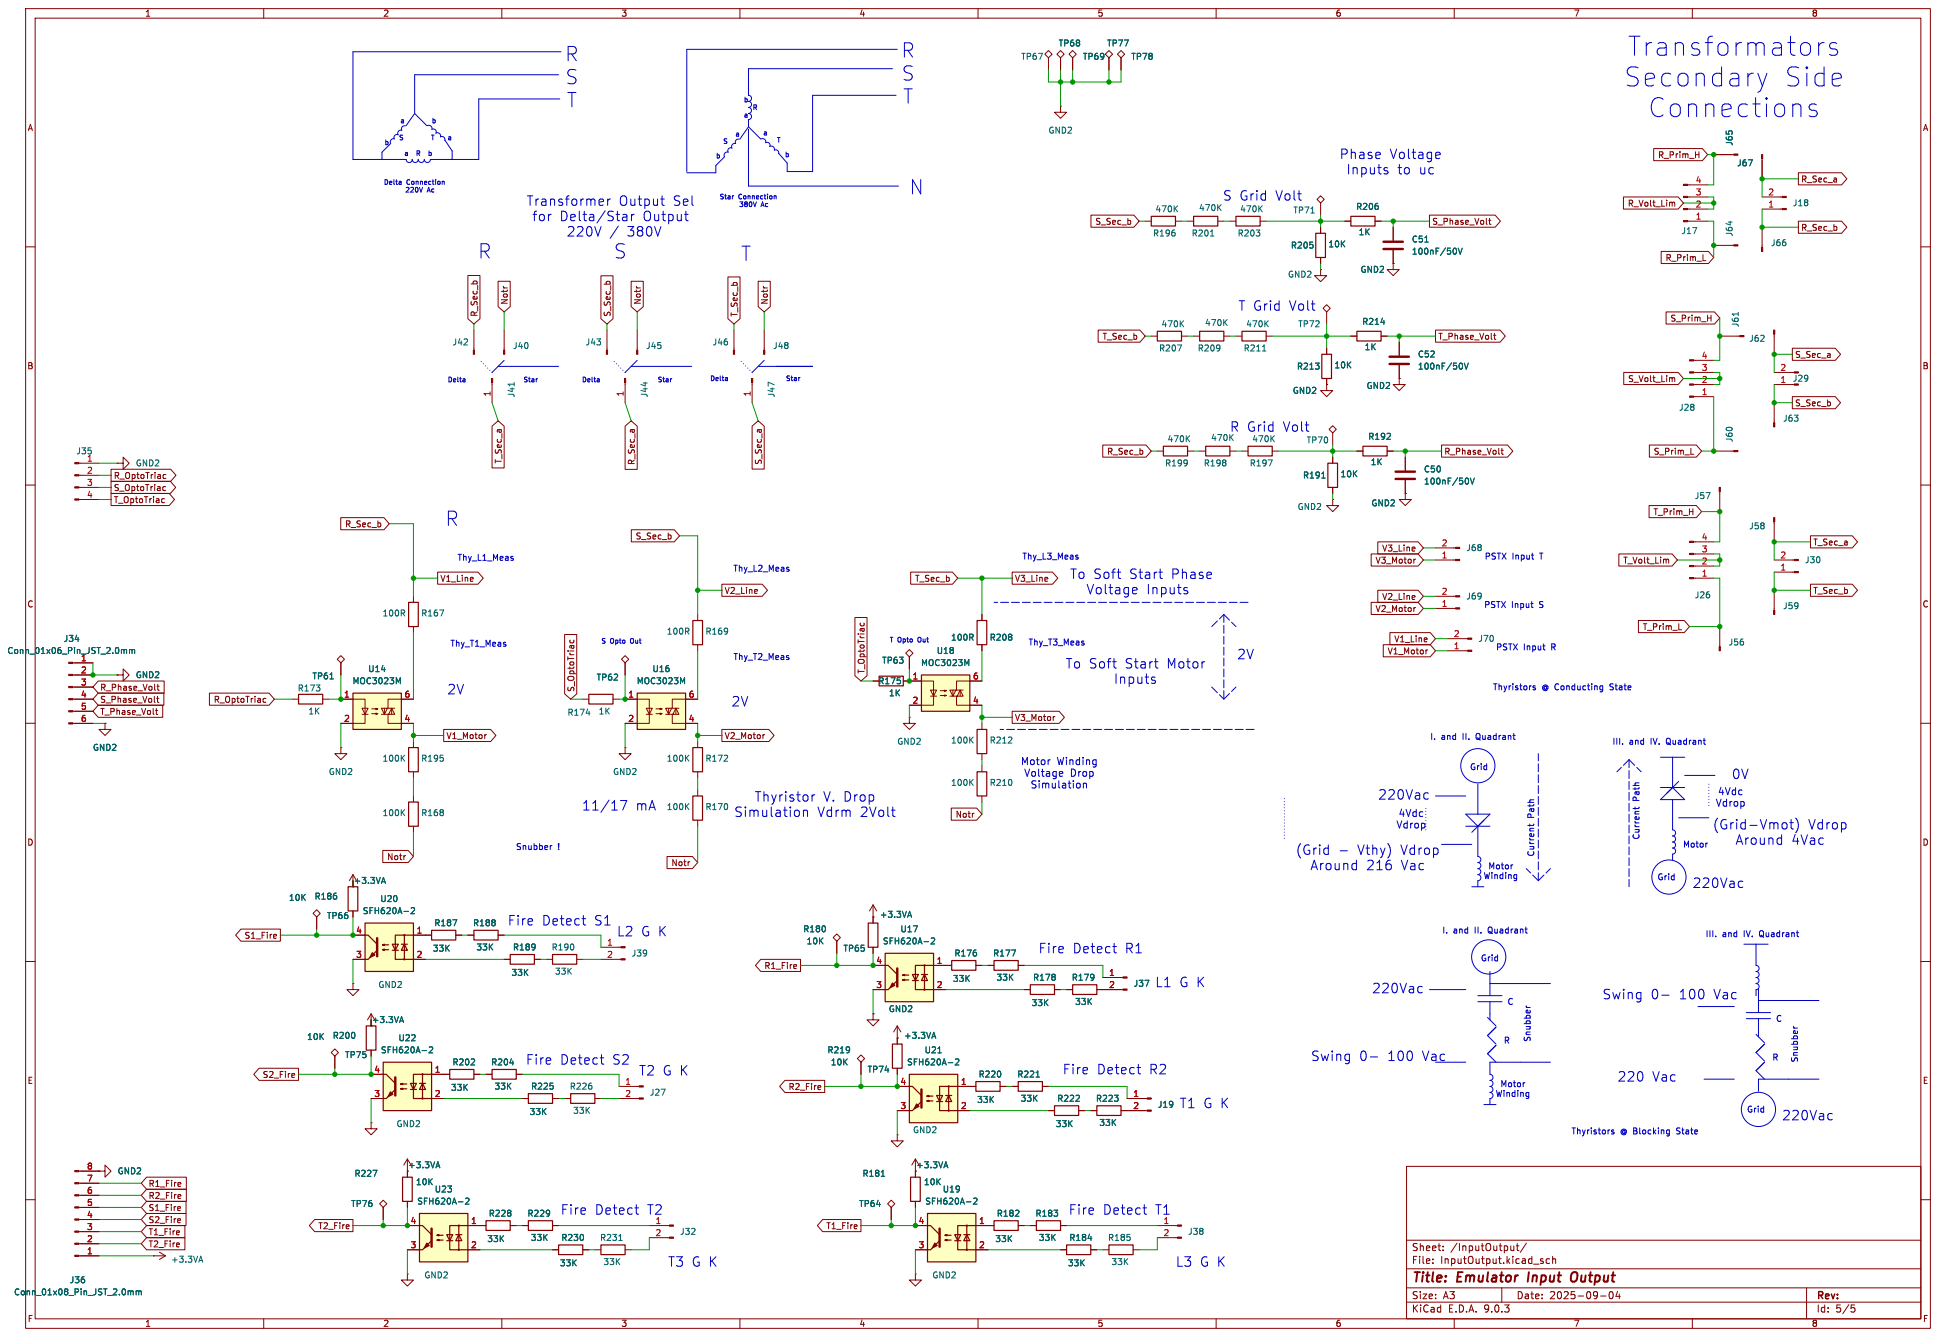
[picture p12: page 5]

Inputs to uc R Grid Volt
S Grid Volt

T Grid Volt Star Connection

To Soft Start Phase
Voltage Inputs

Thy_T3_Meas
To Soft Start Motor

III. and IV. Quadrant Swing 0- 100 Vac

I. and II. Quadrant Motor Winding
Voltage Drop
Simulation

III. and IV. Quadrant
