ilkerya/Emulator_PCB/PSTX_Topology.pdf

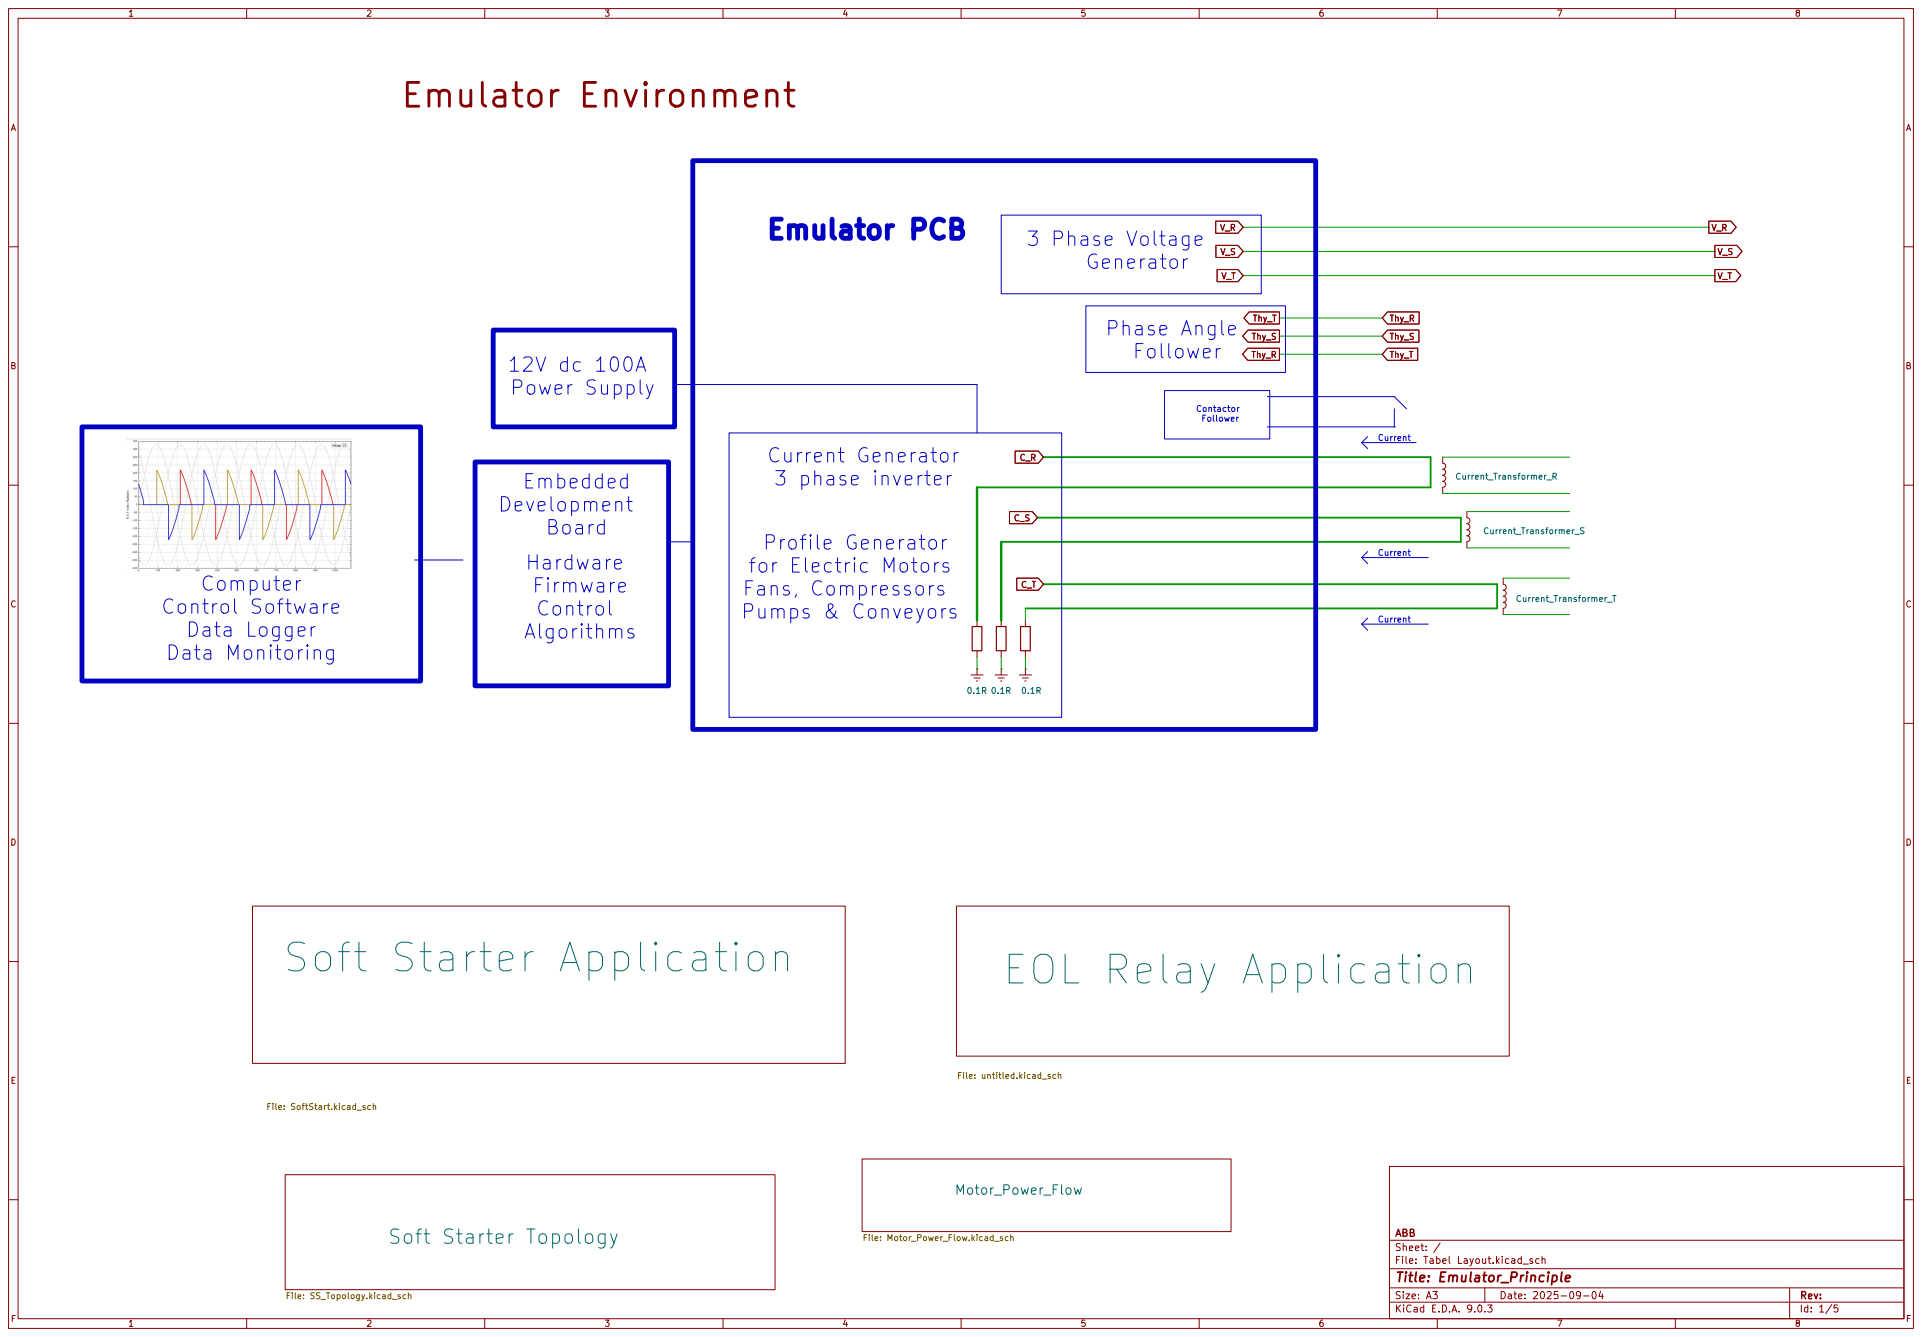
[picture p13: page 1]

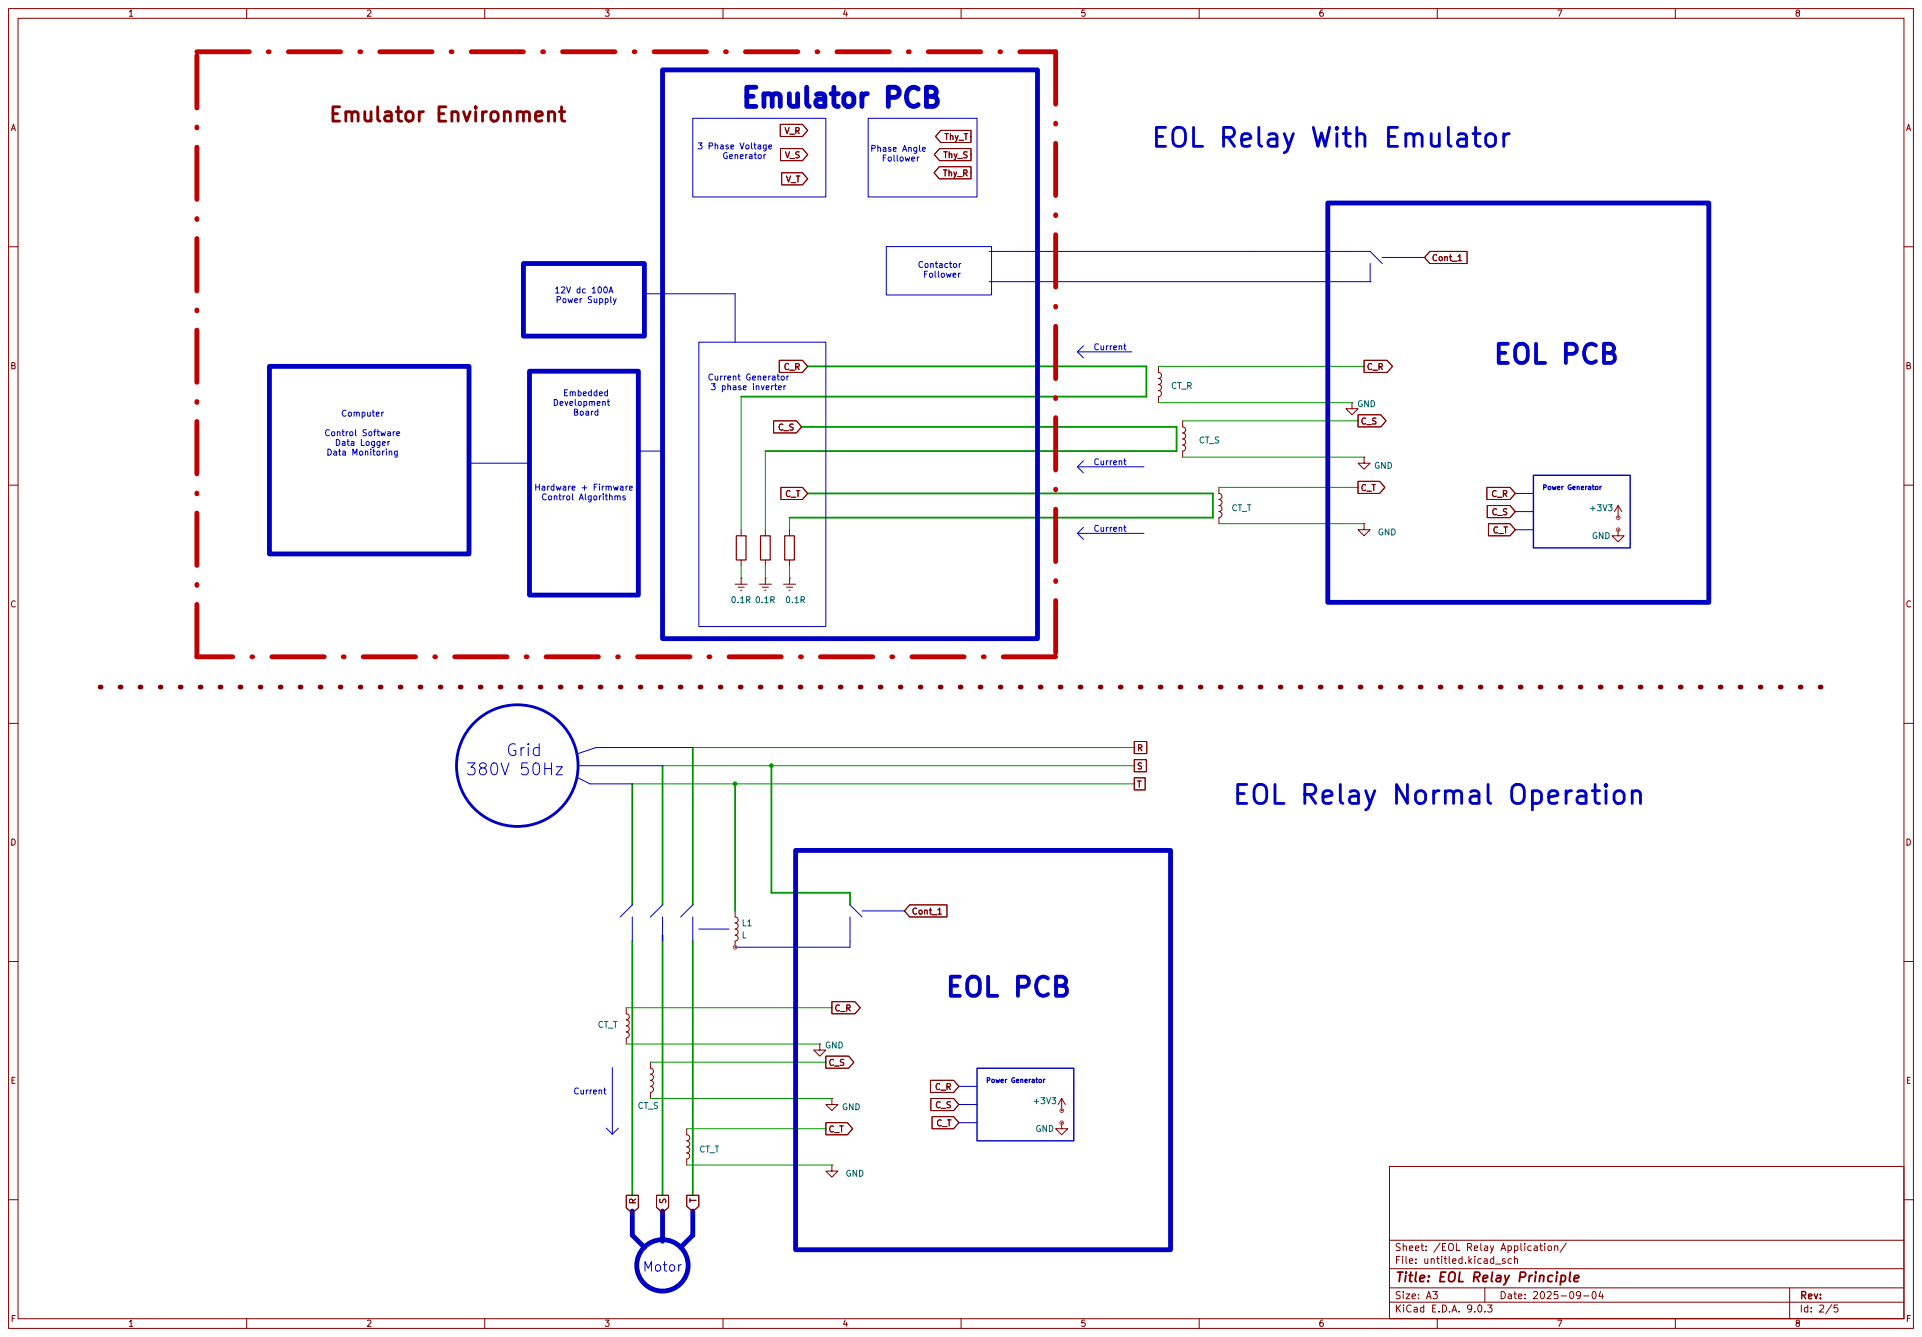
[picture p14: page 2]

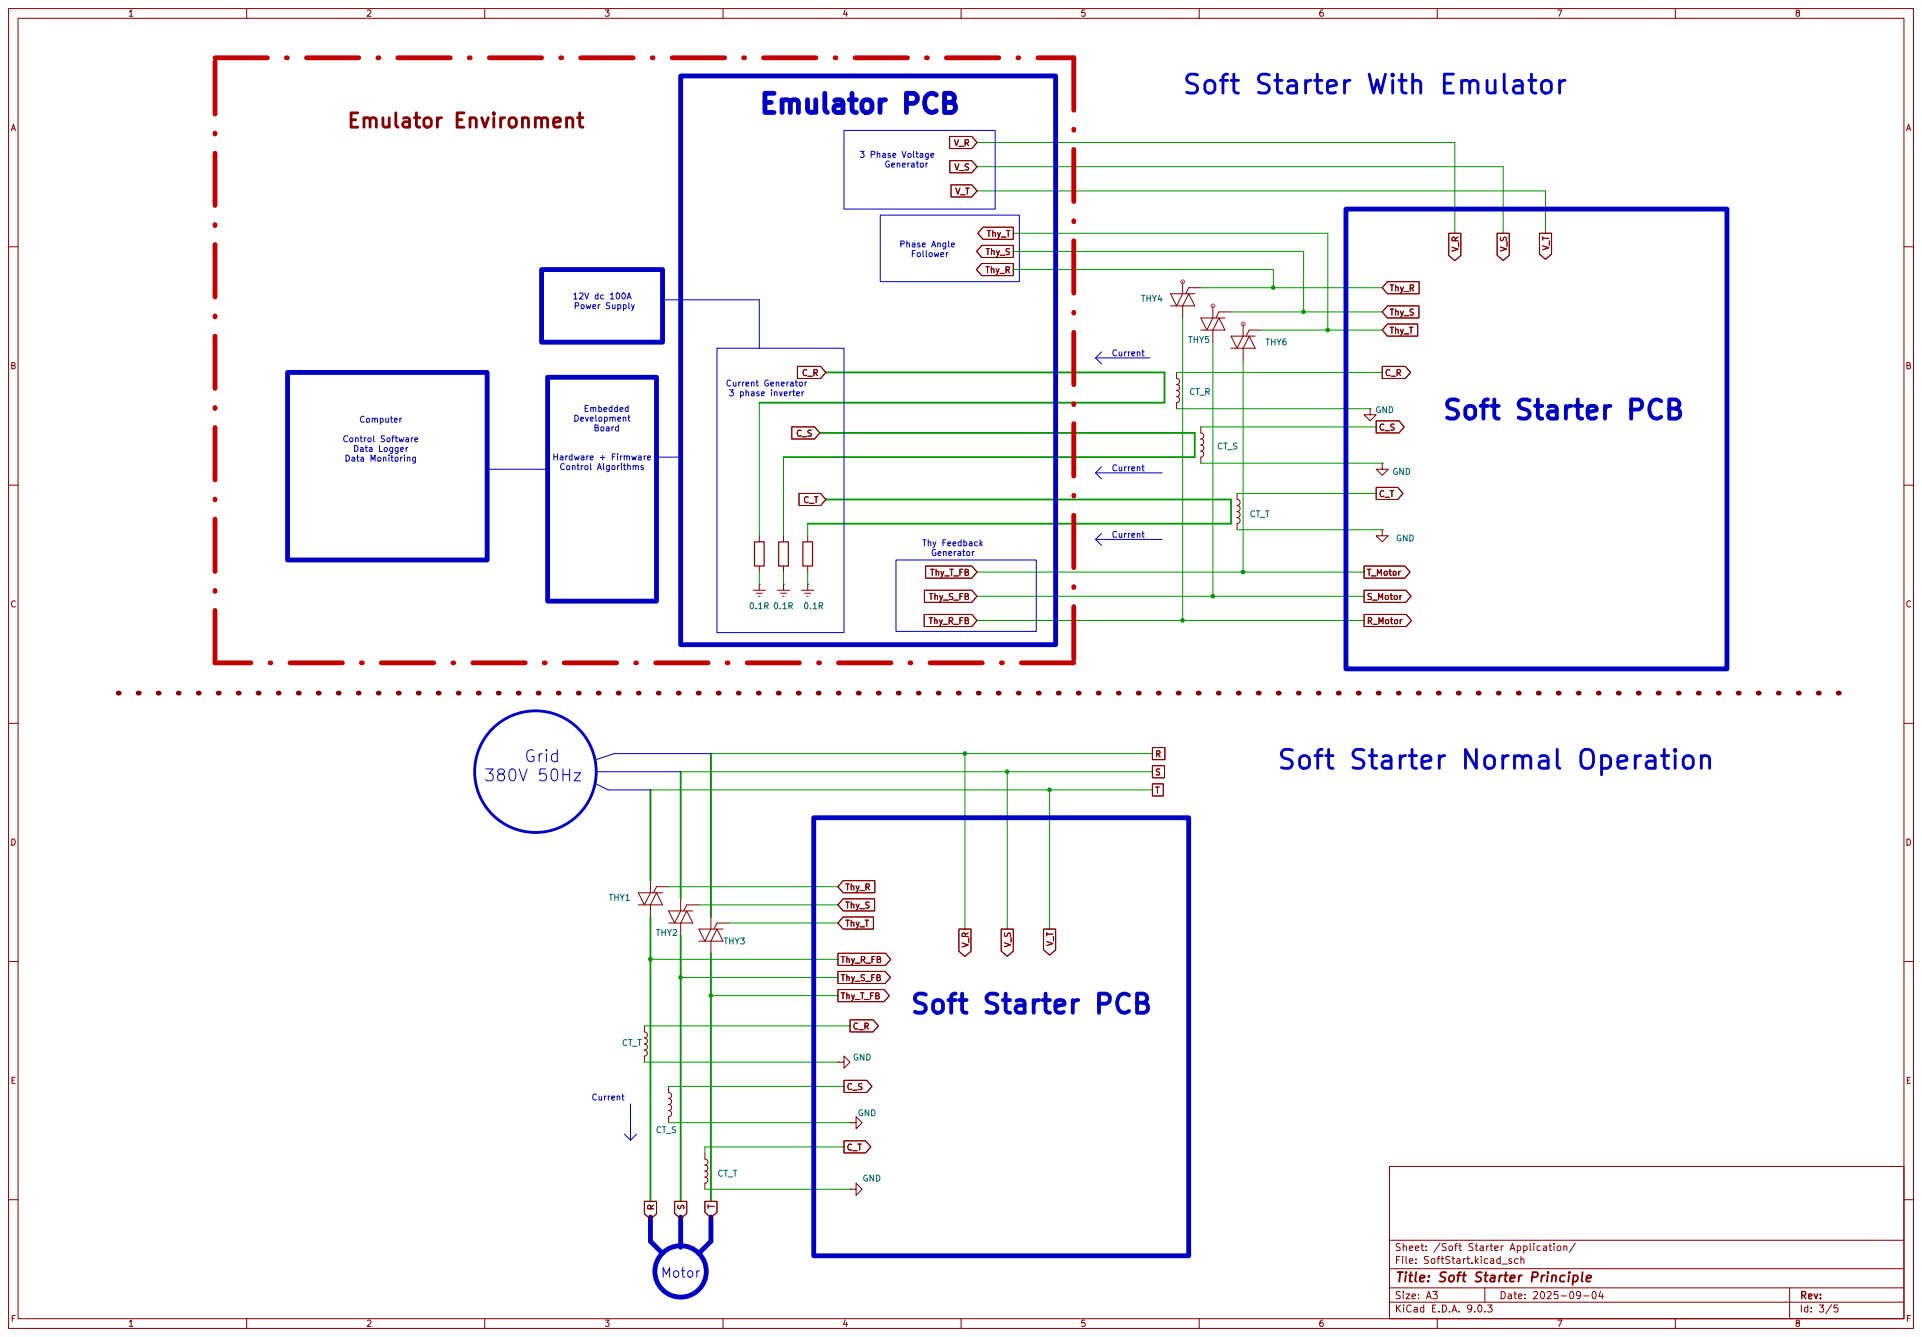
[picture p15: page 3]

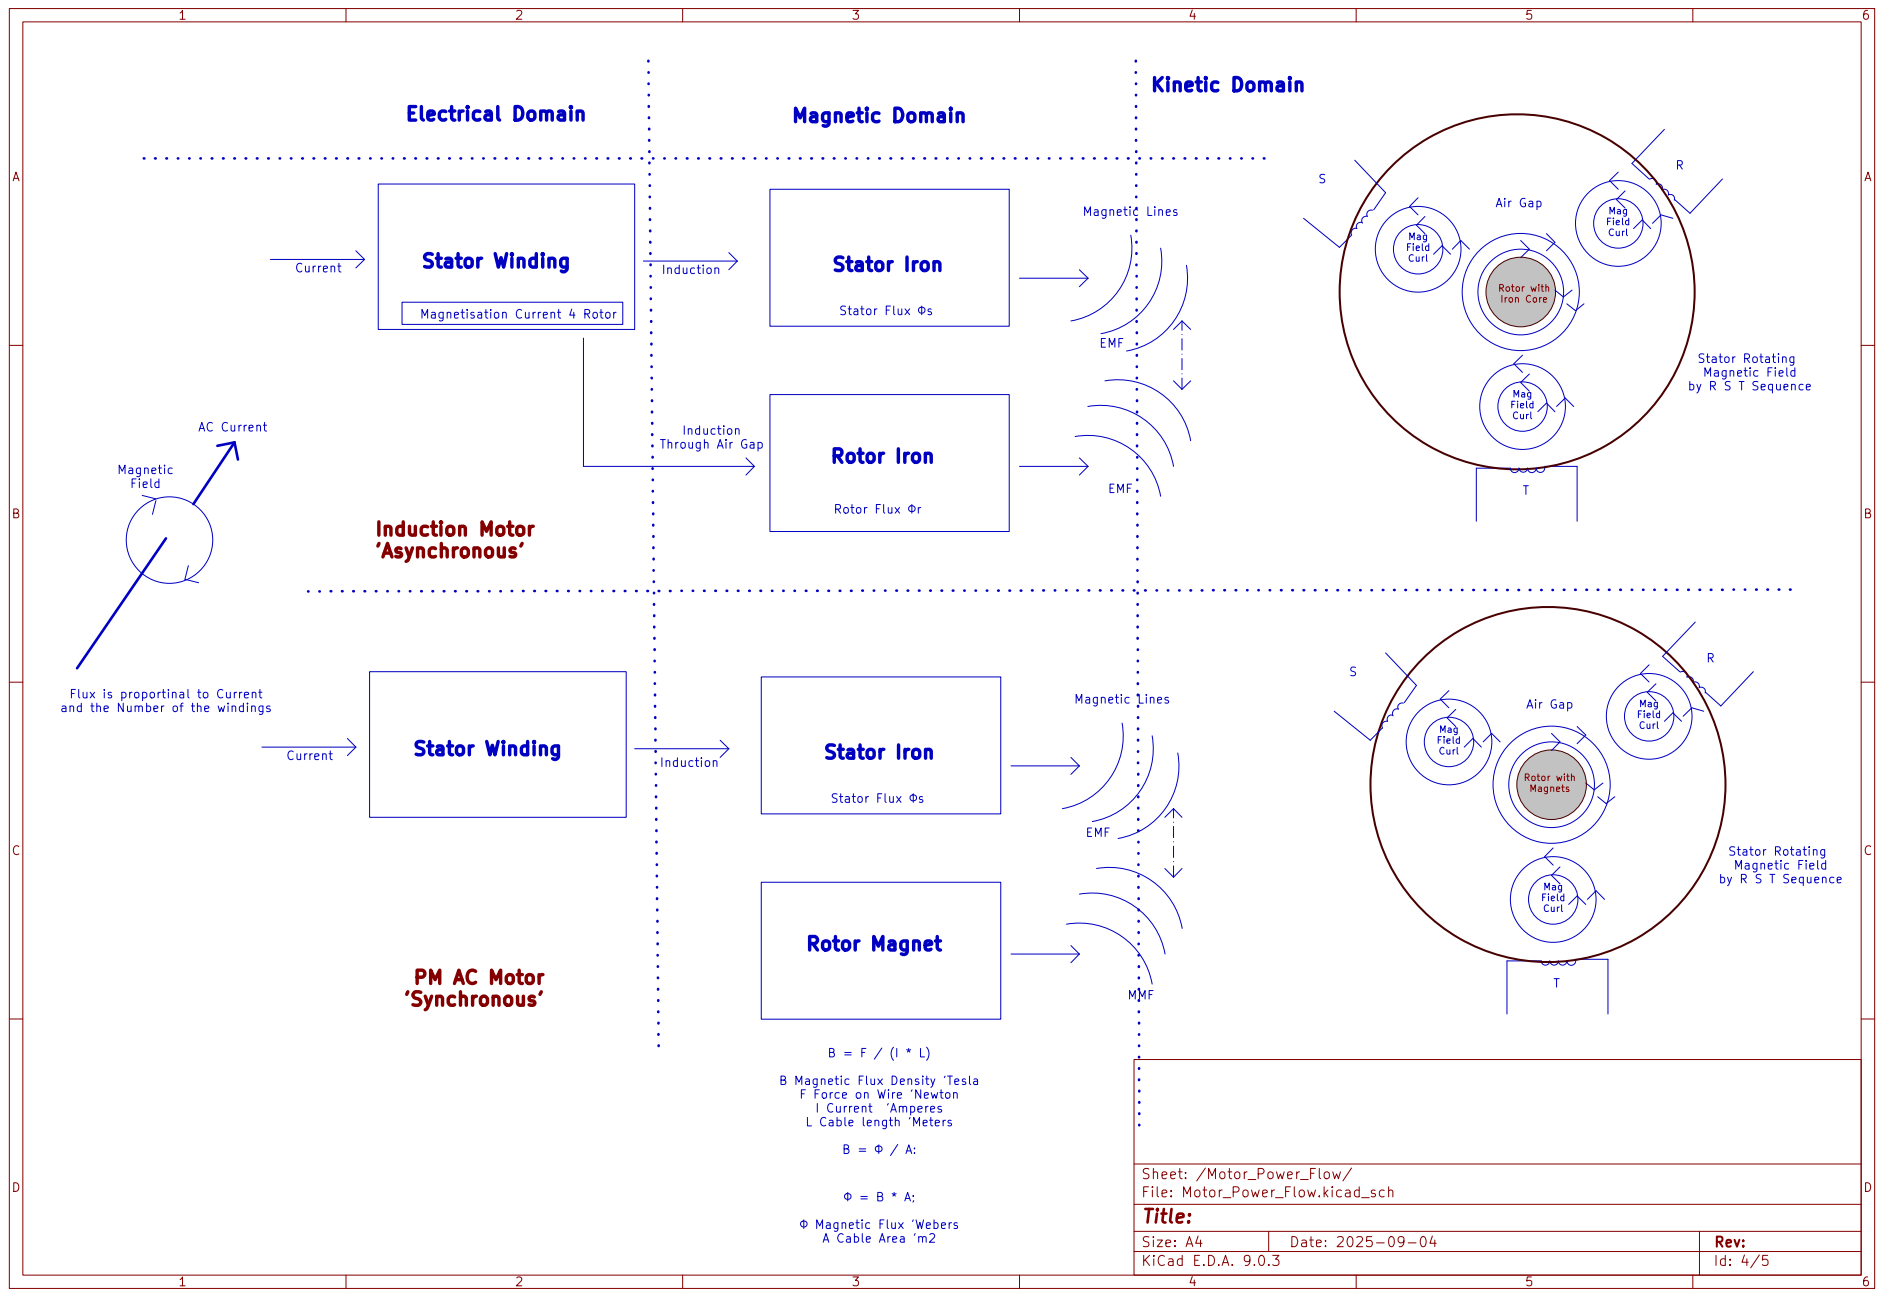
[picture p16: page 4]

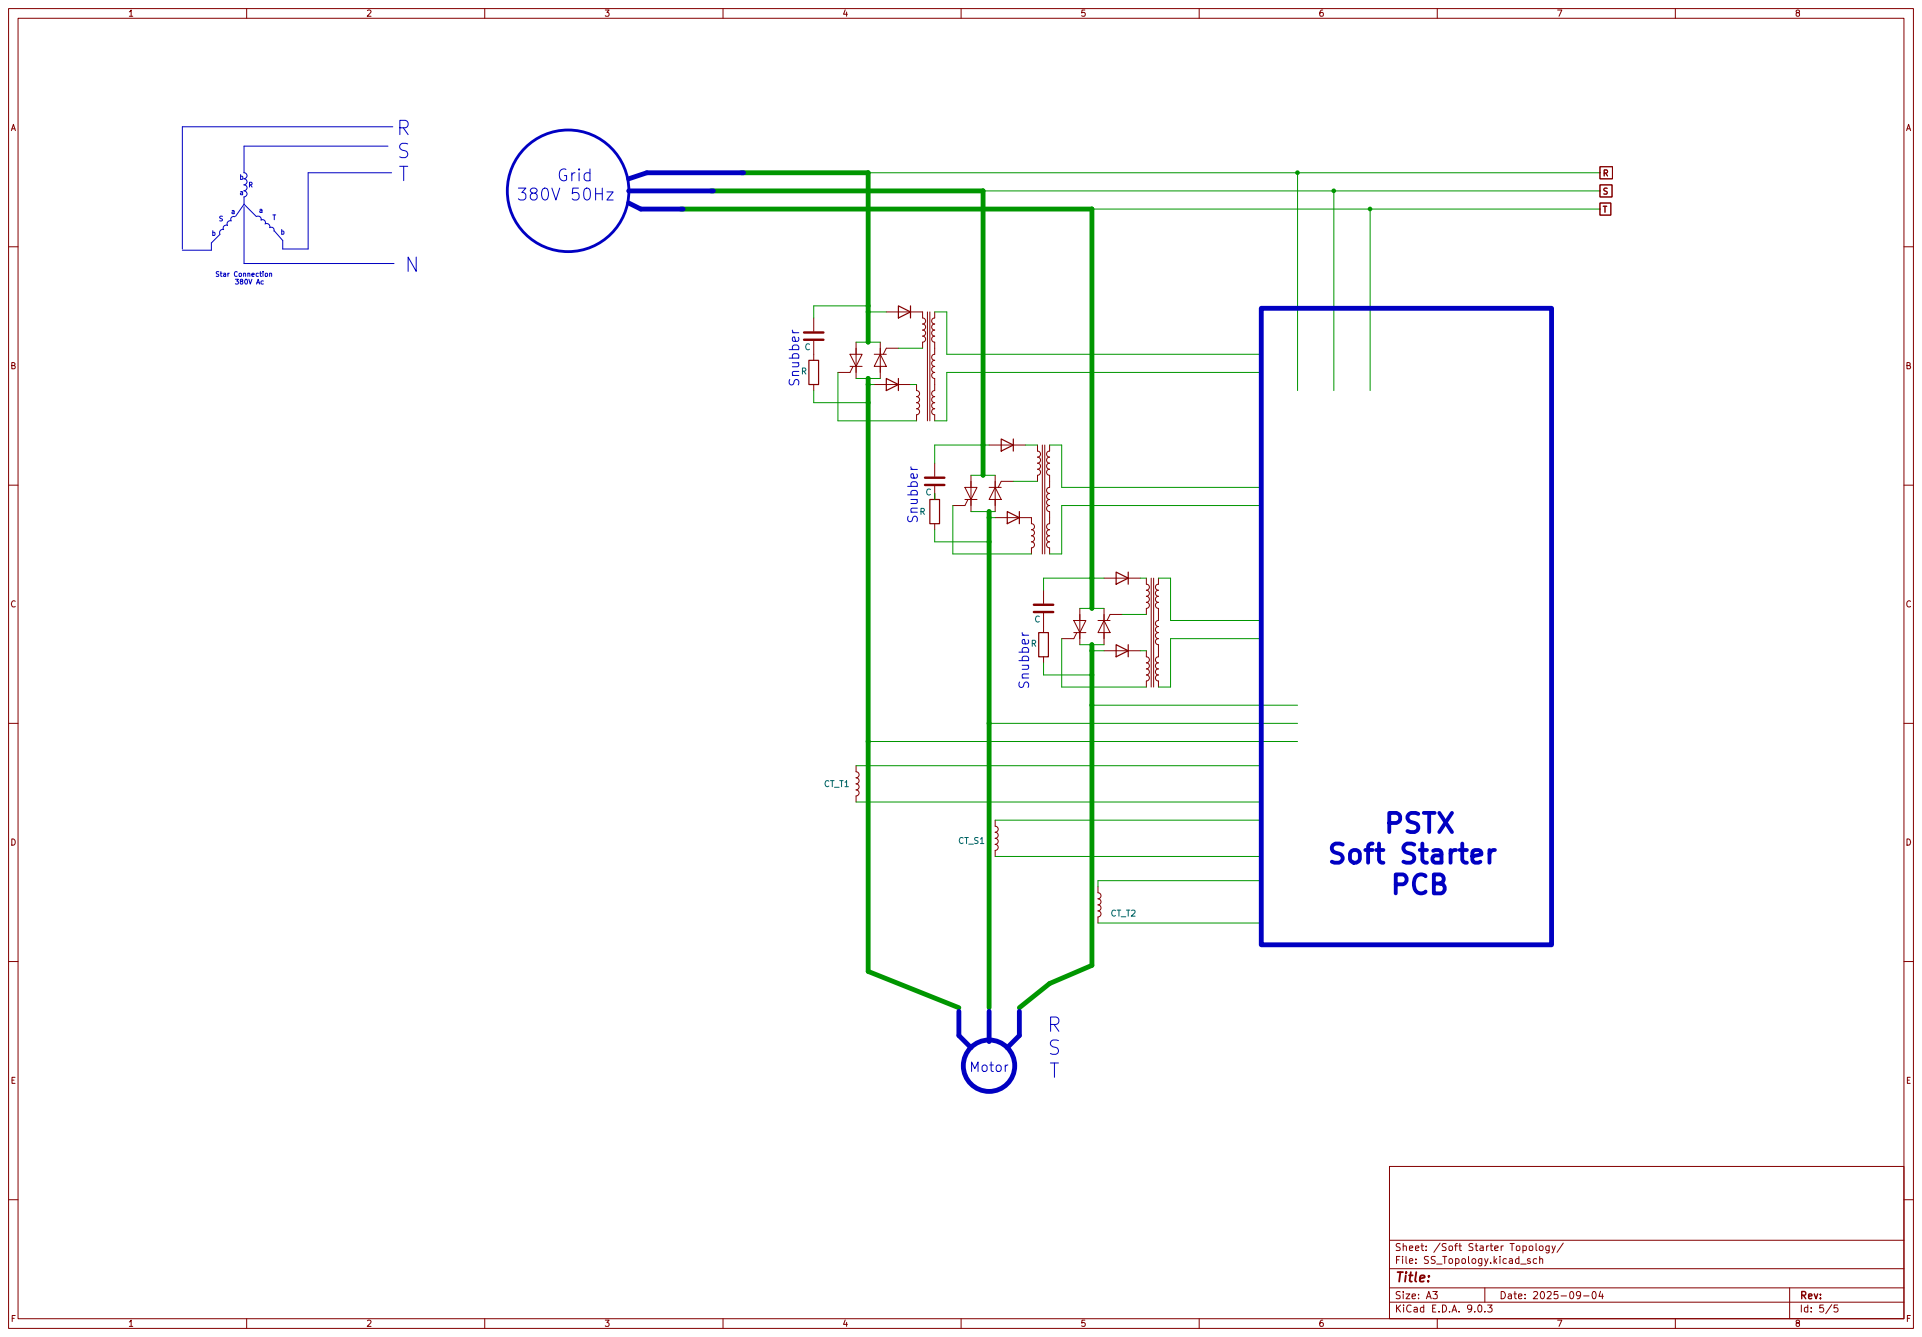
[picture p17: page 5]
