ilkerya/Emulator_PCB/Cur_Emul/Cur_Emul.kicad_pcb

## KiCad design Cur_Emul/Cur_Emul.kicad_pcb (2025-10-06)

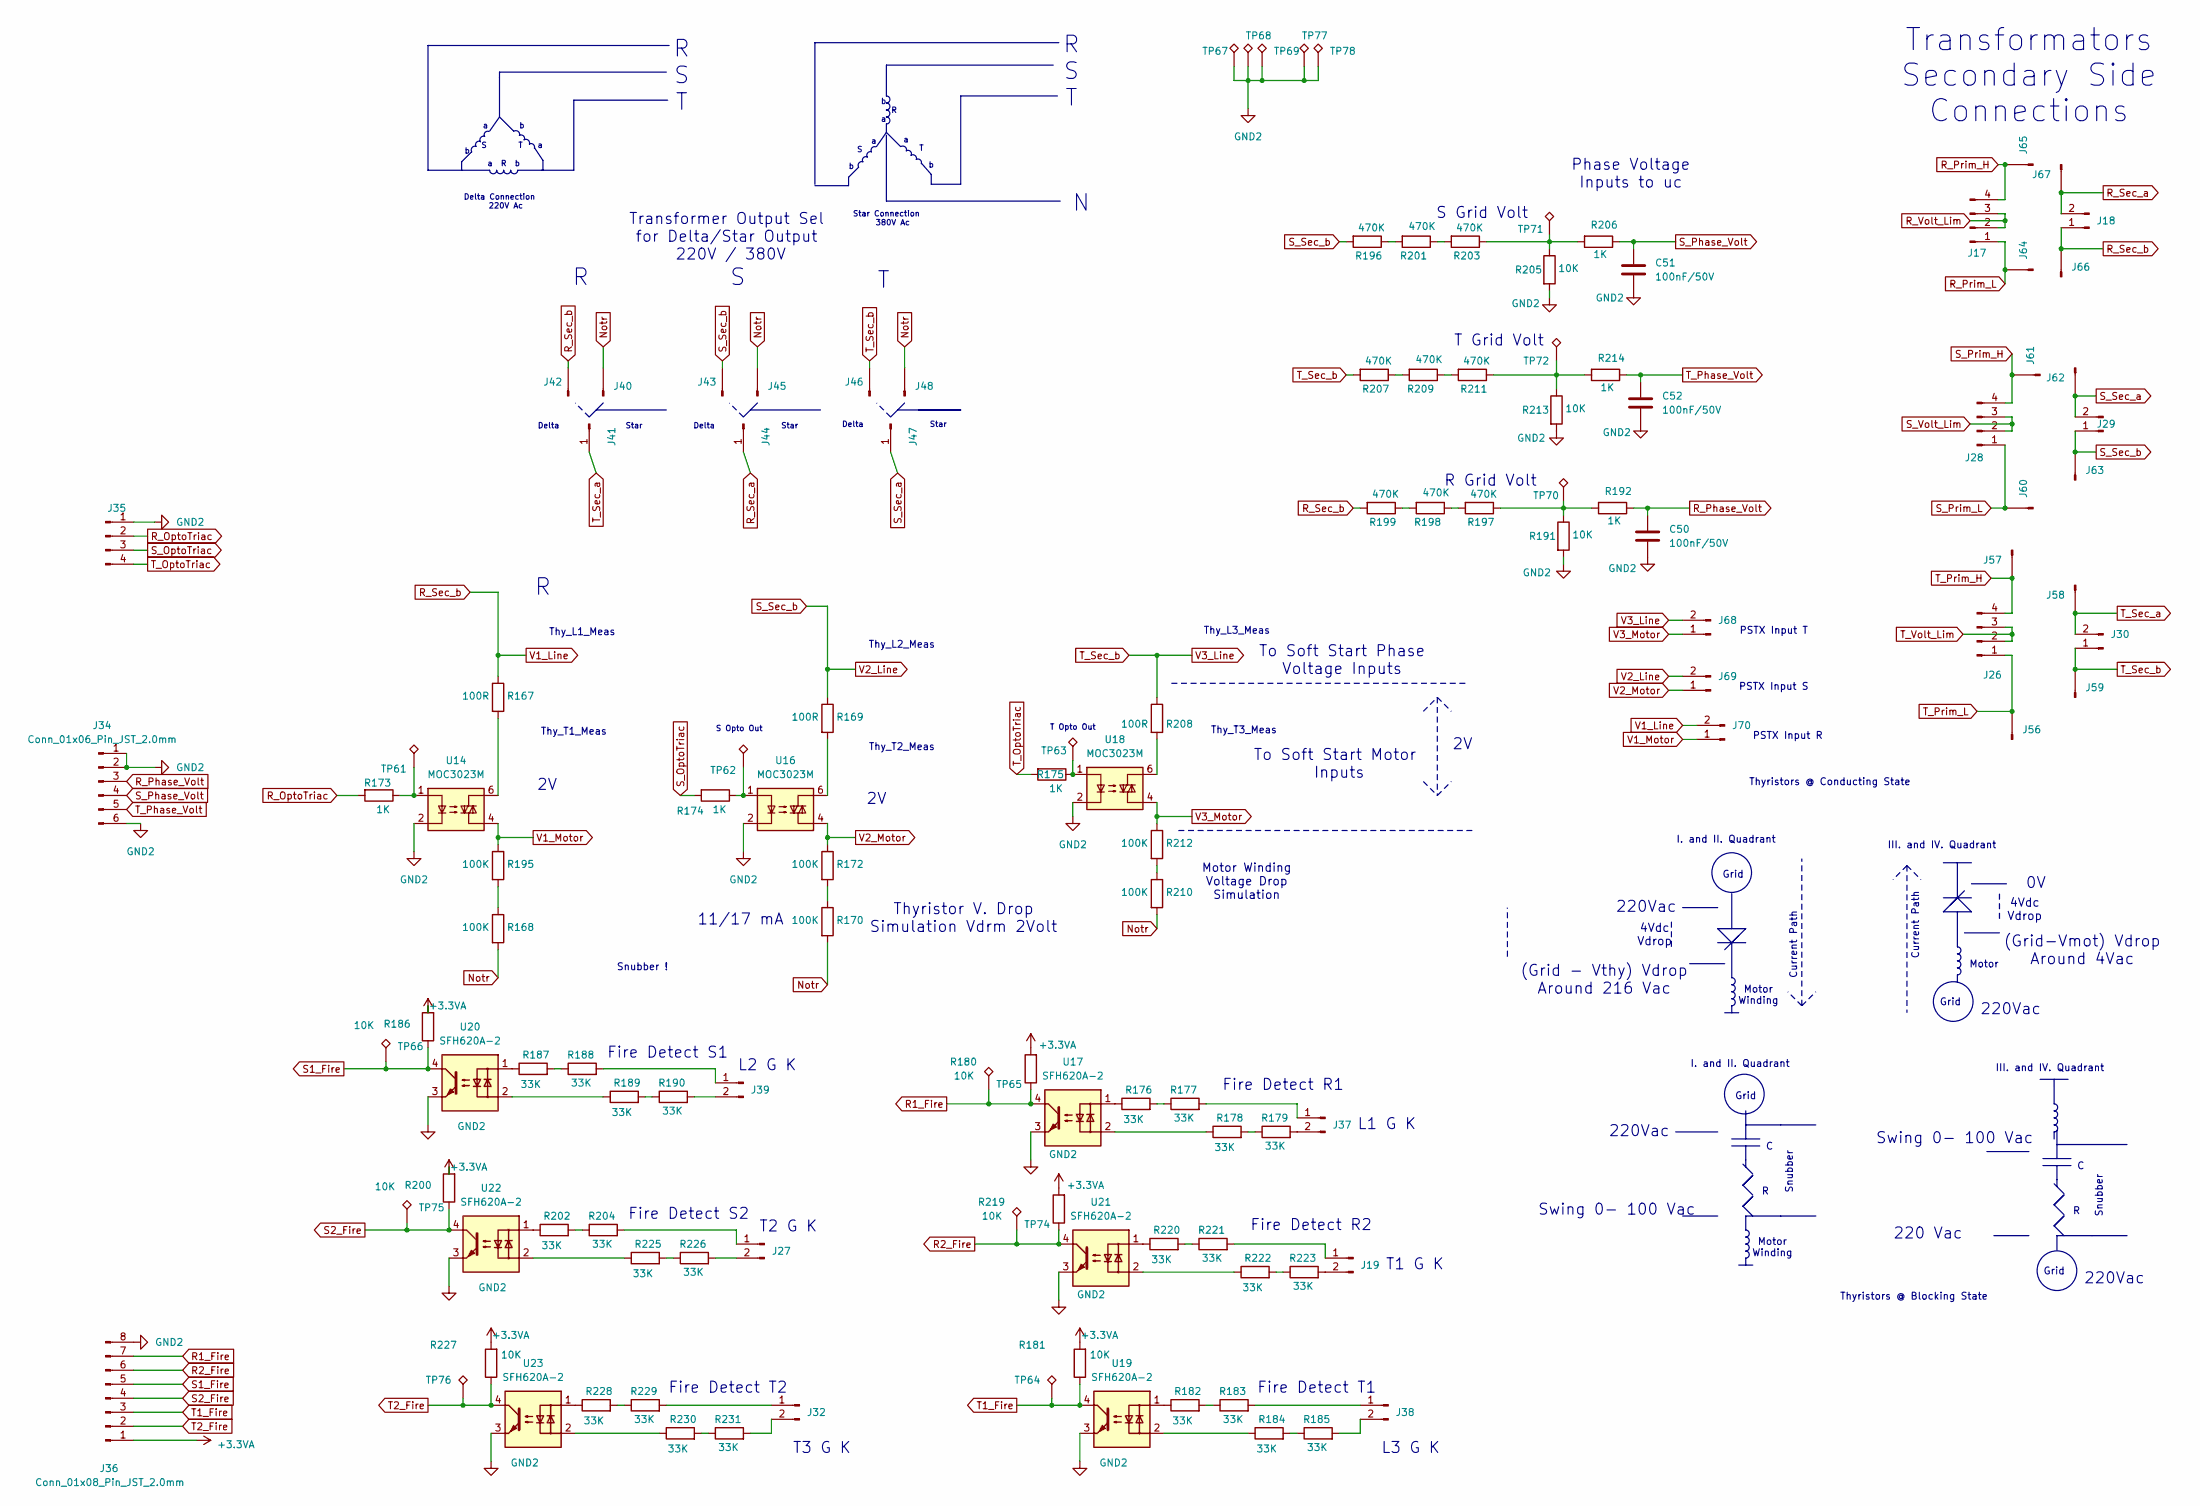
[picture p18: schematic InputOutput.kicad_sch, Emulator Input Output]

Parts:
C50, C51, C52: 100nF/50V; C_Rect_L7.0mm_W2.0mm_P5.00mm
J17, J26, J28: Conn_01x04_Pin_JST_2.5mm; JST_EH_B4B-EH-A_1x04_P2.50mm_Vertical
J18, J29, J30, J68, J69, J70: 2x7.50mm_Vertical_PhoenixContact_GMSTB; PhoenixContact_GMSTBVA_2,5_2-G_1x02_P7.50mm_Vertical
J19, J27, J32, J37, J38, J39: 2x7.50mm_Horizontal_PhoenixContact_GMSTBA; PhoenixContact_GMSTBA_2,5_2-G_1x02_P7.50mm_Horizontal
J34: Conn_01x06_Pin_JST_2.0mm; JST_PH_B6B-PH-K_1x06_P2.00mm_Vertical
J35: Conn_01x04_Pin_JST_2.0mm; JST_PH_B4B-PH-K_1x04_P2.00mm_Vertical
J36: Conn_01x08_Pin_JST_2.0mm; JST_PH_B8B-PH-K_1x08_P2.00mm_Vertical
J40, J41, J42, J43, J44, J45, J46, J47, J48, J56, J57, J58, J59, J60, J61, J62, J63, J64, J65, J66, J67: PinHeader_1x2.54mm; PinHeader_1x01_P2.54mm_Vertical
R167, R169, R208: 100R; R_Axial_DIN0207_L6.3mm_D2.5mm_P7.62mm_Horizontal
R168, R170, R172, R195, R210, R212: 100K; R_Axial_DIN0207_L6.3mm_D2.5mm_P7.62mm_Horizontal
R173, R174, R175, R192, R206, R214: 1K; R_Axial_DIN0207_L6.3mm_D2.5mm_P7.62mm_Horizontal
R176, R177, R178, R179, R182, R183, R184, R185, R187, R188, R189, R190, R202, R204, R220, R221, R222, R223, R225, R226, R228, R229, R230, R231: 33K; R_Axial_DIN0207_L6.3mm_D2.5mm_P7.62mm_Horizontal
R180, R181, R186, R191, R200, R205, R213, R219, R227: 10K; R_Axial_DIN0207_L6.3mm_D2.5mm_P7.62mm_Horizontal
R196, R197, R198, R199, R201, R203, R207, R209, R211: 470K; R_Axial_DIN0207_L6.3mm_D2.5mm_P7.62mm_Horizontal
TP61, TP62, TP63, TP64, TP65, TP66, TP67, TP68, TP69, TP70, TP71, TP72, TP74, TP75, TP76, TP77, TP78: Test_Point_THT_KeyStone; TestPoint_Loop_D1.80mm_Drill1.0mm_Beaded
U14, U16, U18: MOC3023M; DIP-6_W7.62mm
U17, U19, U20, U21, U22, U23: SFH620A-2; DIP-4_W7.62mm

Connections:
+3.3VA: J36.1, R180.2, R181.2, R186.2, R200.2, R219.2, R227.2; also elsewhere on the board
GND2: C50.2, C51.2, C52.2, J34.1, J34.2, J34.6, J35.1, J36.8, R191.2, R205.2, R213.2, TP67.1, TP68.1, TP69.1, TP77.1, TP78.1, U14.2, U16.2, U17.3, U18.2, U19.3, U20.3, U21.3, U22.3, U23.3; also elsewhere on the board
unnamed: J19.1, R221.2
unnamed: J19.2, R223.2
unnamed: J27.1, R204.2
unnamed: J27.2, R226.2
unnamed: J32.1, R229.2
unnamed: J32.2, R231.2
unnamed: J37.1, R177.2
unnamed: J37.2, R179.2
unnamed: J38.1, R183.2
unnamed: J38.2, R185.2
unnamed: J39.1, R188.2
unnamed: J39.2, R190.2
unnamed: R167.2, U14.6
unnamed: R168.1, R195.2
unnamed: R169.2, U16.6
unnamed: R170.1, R172.2
unnamed: R173.1, TP61.1, U14.1
unnamed: R174.1, TP62.1, U16.1
unnamed: R175.1, TP63.1, U18.1
unnamed: R176.1, U17.1
unnamed: R176.2, R177.1
unnamed: R178.1, U17.2
unnamed: R178.2, R179.1
unnamed: R182.1, U19.1
unnamed: R182.2, R183.1
unnamed: R184.1, U19.2
unnamed: R184.2, R185.1
unnamed: R187.1, U20.1
unnamed: R187.2, R188.1
unnamed: R189.1, U20.2
unnamed: R189.2, R190.1
unnamed: R191.1, R192.2, R197.1, TP70.1
unnamed: R196.1, R201.2
unnamed: R197.2, R198.1
unnamed: R198.2, R199.1
unnamed: R201.1, R203.2
unnamed: R202.1, U22.1
unnamed: R202.2, R204.1
unnamed: R203.1, R205.1, R206.2, TP71.1
unnamed: R207.1, R209.2
unnamed: R208.2, U18.6
unnamed: R209.1, R211.2
unnamed: R210.1, R212.2
unnamed: R211.1, R213.1, R214.2, TP72.1
unnamed: R220.1, U21.1
unnamed: R220.2, R221.1
unnamed: R222.1, U21.2
unnamed: R222.2, R223.1
unnamed: R225.1, U22.2
unnamed: R225.2, R226.1
unnamed: R228.1, U23.1
unnamed: R228.2, R229.1
unnamed: R230.1, U23.2
unnamed: R230.2, R231.1
Notr: J40.1, J45.1, J48.1, R168.2, R170.2, R210.2
R1_Fire: J36.7, R180.1, TP65.1, U17.4
R2_Fire: J36.6, R219.1, TP74.1, U21.4
R_OptoTriac: J35.2, R173.2
R_Phase_Volt: C50.1, J34.3, R192.1
R_Prim_H: J17.4, J65.1; also elsewhere on the board
R_Prim_L: J17.1, J64.1; also elsewhere on the board
R_Sec_a: J18.2, J44.1, J67.1; also elsewhere on the board
R_Sec_b: J18.1, J42.1, J66.1, J70.2, R167.1, R199.2; also elsewhere on the board
R_Volt_Lim: J17.2, J17.3; also elsewhere on the board
S1_Fire: J36.5, R186.1, TP66.1, U20.4
S2_Fire: J36.4, R200.1, TP75.1, U22.4
S_OptoTriac: J35.3, R174.2
S_Phase_Volt: C51.1, J34.4, R206.1
S_Prim_H: J28.4, J61.1; also elsewhere on the board
S_Prim_L: J28.1, J60.1; also elsewhere on the board
S_Sec_a: J29.2, J47.1, J62.1; also elsewhere on the board
S_Sec_b: J29.1, J43.1, J63.1, J69.2, R169.1, R196.2; also elsewhere on the board
S_Volt_Lim: J28.2, J28.3; also elsewhere on the board
T1_Fire: J36.3, R181.1, TP64.1, U19.4
T2_Fire: J36.2, R227.1, TP76.1, U23.4
T_OptoTriac: J35.4, R175.2
T_Phase_Volt: C52.1, J34.5, R214.1
T_Prim_H: J26.4, J57.1; also elsewhere on the board
T_Prim_L: J26.1, J56.1; also elsewhere on the board
T_Sec_a: J30.2, J41.1, J58.1; also elsewhere on the board
T_Sec_b: J30.1, J46.1, J59.1, J68.2, R207.2, R208.1; also elsewhere on the board
T_Volt_Lim: J26.2, J26.3; also elsewhere on the board
V1_Motor: J70.1, R195.1, U14.4
V2_Motor: J69.1, R172.1, U16.4
V3_Motor: J68.1, R212.1, U18.4

Notes on the sheet:
Thy_L3_Meas
Motor Winding
Fire Detect R1
Fire Detect T2
I. and II. Quadrant
Thy_T2_Meas
Transformators Secondary Side Connections
Thy_L1_Meas
Fire Detect S1
4Vdc Vdrop
T2 G K
Phase Voltage Inputs to uc
S Grid Volt
Snubber
S Opto Out
Grid
Delta
11/17 mA
Delta Connection 220V Ac
To Soft Start Phase Voltage Inputs
Thy_T3_Meas
Star
Swing 0- 100 Vac
Current Path
Motor Winding Voltage Drop Simulation
III. and IV. Quadrant
220Vac
a R b
Motor
Thy_L2_Meas
Thyristors @ Conducting State
PSTX Input T
PSTX Input R
L3 G K
Fire Detect R2
L2 G K
Fire Detect T1
Thyristors @ Blocking State
To Soft Start Motor Inputs
L1 G K
R Grid Volt
R S T
Star Connection 380V Ac
T Opto Out
(Grid - Vthy) Vdrop Around 216 Vac
Thyristor V. Drop Simulation Vdrm 2Volt
T Grid Volt
PSTX Input S
T3 G K
Transformer Output Sel for Delta/Star Output 220V / 380V
b R a
T1 G K
Thy_T1_Meas
220 Vac
Snubber !
(Grid-Vmot) Vdrop Around 4Vac
Fire Detect S2

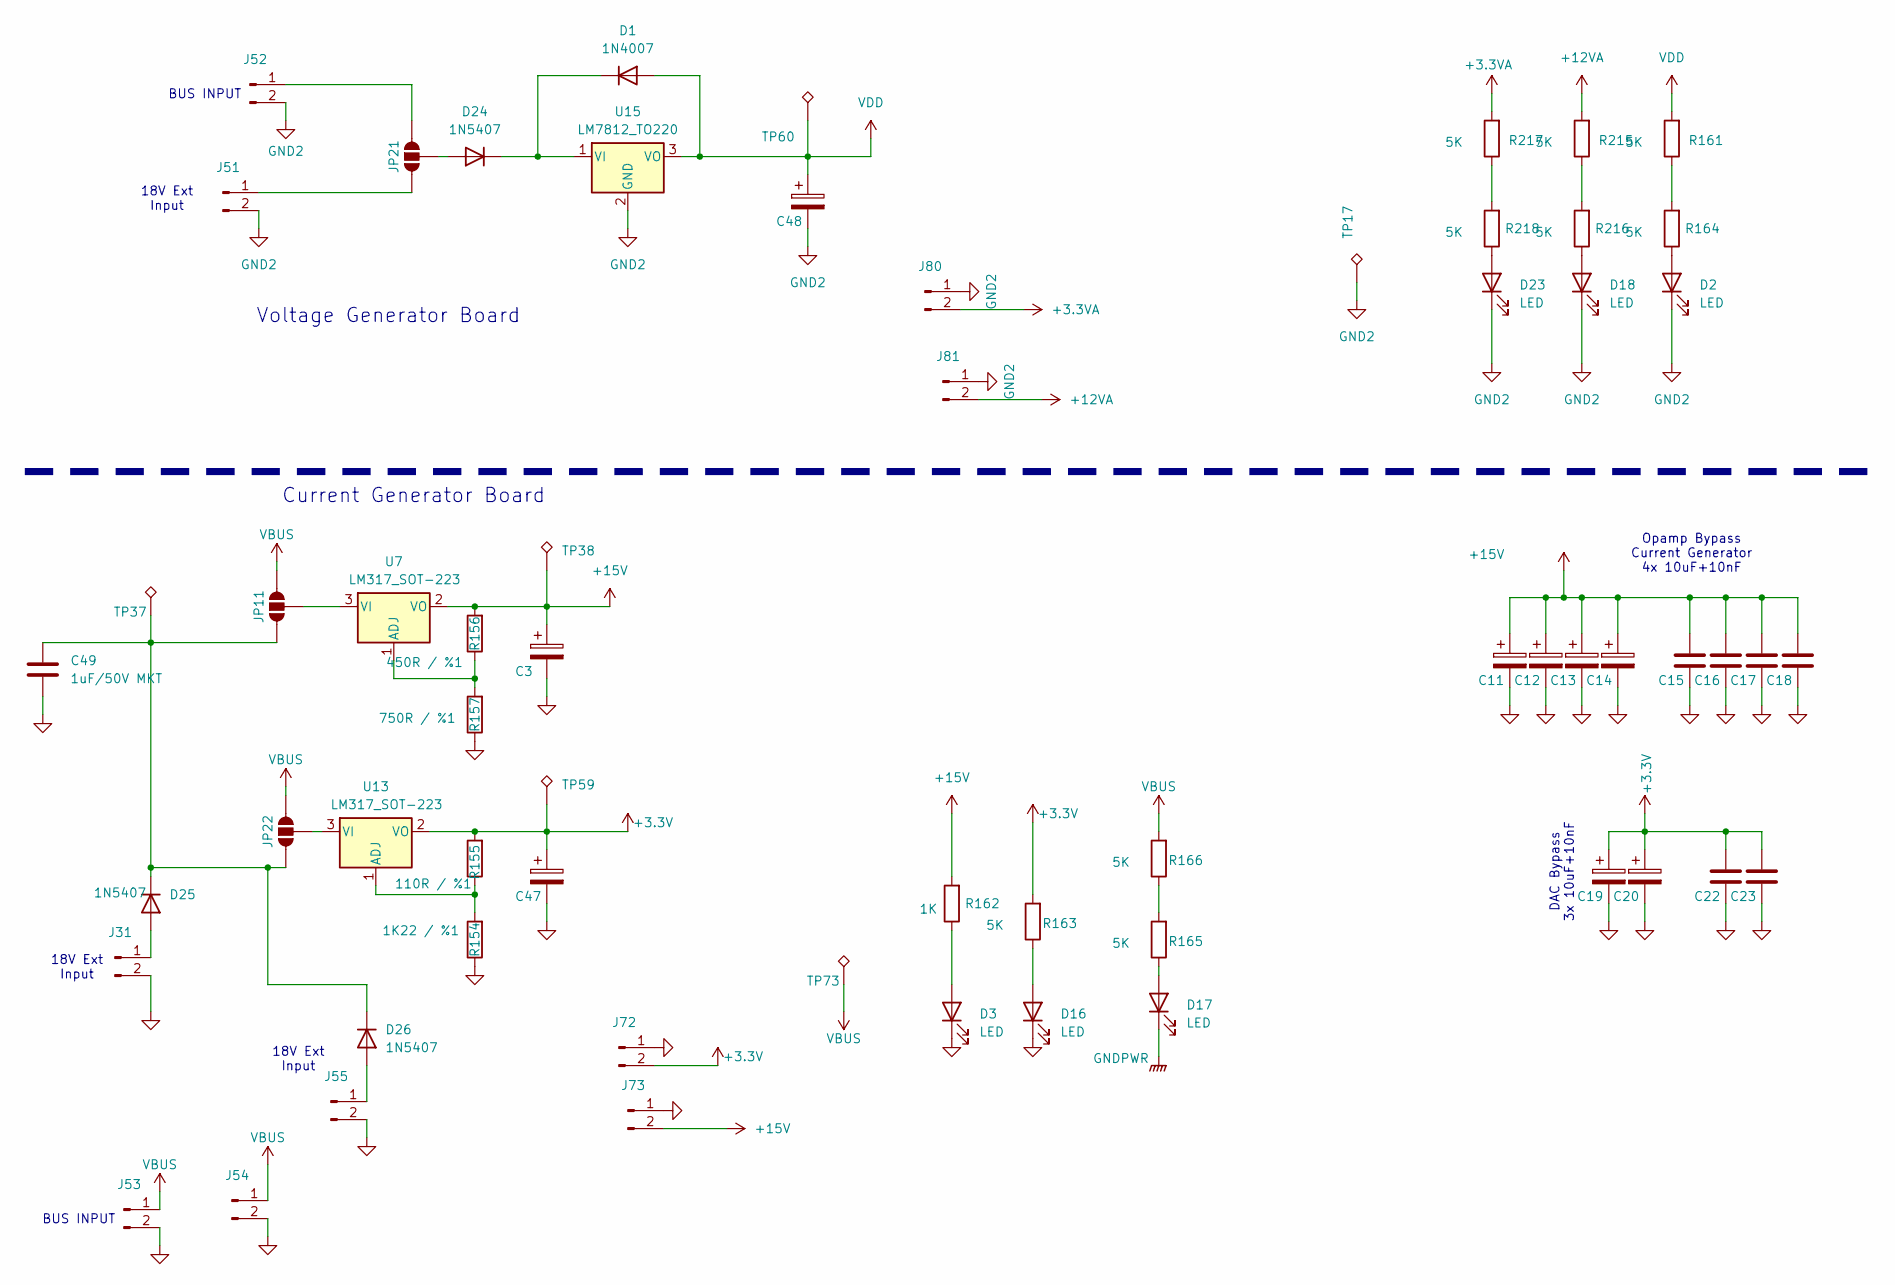
[picture p19: schematic P_Supply.kicad_sch, Emulator Power Supply]

Parts:
C3, C47: 100uF/50V; CP_Elec_6.3x7.7
C11, C12, C13, C14, C19, C20: 10uF/50V; CP_Elec_4x3.9
C15, C16, C17, C18, C22, C23: 10nF/50V; C_0805_2012Metric_Pad1.18x1.45mm_HandSolder
C48: 1000uF/50V; CP_Radial_D24.0mm_P10.00mm_SnapIn
C49: 1uF/50V MKT; C_Rect_L28.0mm_W12.0mm_P22.50mm_MKS4
D1: 1N4007; D_DO-41_SOD81_P10.16mm_Horizontal
D2, D3, D16, D17, D18, D23: LED; LED_0805_2012Metric_Pad1.15x1.40mm_HandSolder
D24, D25, D26: 1N5407; D_DO-201AD_P15.24mm_Horizontal
J31, J51, J52, J53, J54, J55, J72, J73, J80, J81: 2x7.50mm_Horizontal_PhoenixContact_GMSTBA; PhoenixContact_GMSTBA_2,5_2-G_1x02_P7.50mm_Horizontal
JP11, JP21, JP22: SolderJumper_3_Open; SolderJumper-3_P2.0mm_Open_TrianglePad1.0x1.5mm
R154: 1K22 / %1; R_0805_2012Metric_Pad1.20x1.40mm_HandSolder
R155: 110R / %1; R_0805_2012Metric_Pad1.20x1.40mm_HandSolder
R156: 450R / %1; R_0805_2012Metric_Pad1.20x1.40mm_HandSolder
R157: 750R / %1; R_0805_2012Metric_Pad1.20x1.40mm_HandSolder
R161, R163, R164, R165, R166, R215, R216, R217, R218: 5K; R_0805_2012Metric_Pad1.20x1.40mm_HandSolder
R162: 1K; R_0805_2012Metric_Pad1.20x1.40mm_HandSolder
TP17, TP37, TP38, TP59, TP60, TP73: Test_Point_THT_KeyStone; TestPoint_Loop_D1.80mm_Drill1.0mm_Beaded
U7, U13: LM317_SOT-223; SOT-223-3_TabPin2
U15: LM7812_TO220; TO-220-3_Vertical

Connections:
+3.3V: C19.1, C20.1, C22.1, C23.1, C47.1, J72.2, R155.2, R163.2, TP59.1, U13.2 (VO); also elsewhere on the board
+3.3VA: J80.2, R217.2; also elsewhere on the board
+12VA: J81.2, R215.2; also elsewhere on the board
+15V: C3.1, C11.1, C12.1, C13.1, C14.1, C15.1, C16.1, C17.1, C18.1, J73.2, R156.2, R162.2, TP38.1, U7.2 (VO); also elsewhere on the board
GND: C3.2, C11.2, C12.2, C13.2, C14.2, C15.2, C16.2, C17.2, C18.2, C19.2, C20.2, C22.2, C23.2, C47.2, C49.2, D3.1 (K), D16.1 (K), J31.2, J53.2, J54.2, J55.2, J72.1, J73.1, R154.1, R157.1; also elsewhere on the board
GND2: C48.2, D2.1 (K), D18.1 (K), D23.1 (K), J51.2, J52.2, J80.1, J81.1, TP17.1, U15.2 (GND); also elsewhere on the board
GNDPWR: D17.1 (K); also elsewhere on the board
unnamed: D1.1 (K), D24.1 (K), U15.1 (VI)
unnamed: D2.2 (A), R164.1
unnamed: D3.2 (A), R162.1
unnamed: D16.2 (A), R163.1
unnamed: D17.2 (A), R165.1
unnamed: D18.2 (A), R216.1
unnamed: D23.2 (A), R218.1
unnamed: D24.2 (A), JP21.2 (C)
unnamed: D25.2 (A), J31.1
unnamed: C49.1, D25.1 (K), D26.1 (K), JP11.1 (A), JP22.1 (A), TP37.1
unnamed: D26.2 (A), J55.1
unnamed: J51.1, JP21.3 (B)
unnamed: J52.1, JP21.1 (A)
unnamed: JP11.2 (C), U7.3 (VI)
unnamed: JP22.2 (C), U13.3 (VI)
unnamed: R161.1, R164.2
unnamed: R165.2, R166.1
unnamed: R215.1, R216.2
unnamed: R217.1, R218.2
unnamed: R156.1, R157.2, U7.1 (ADJ)
unnamed: R154.2, R155.1, U13.1 (ADJ)
VBUS: J53.1, J54.1, JP11.3 (B), JP22.3 (B), R166.2, TP73.1; also elsewhere on the board
VDD: C48.1, D1.2 (A), R161.2, TP60.1, U15.3 (VO); also elsewhere on the board

Notes on the sheet:
DAC Bypass 3x 10uF+10nF
Current Generator Board
BUS INPUT
Opamp Bypass Current Generator 4x 10uF+10nF
18V Ext Input
Voltage Generator Board

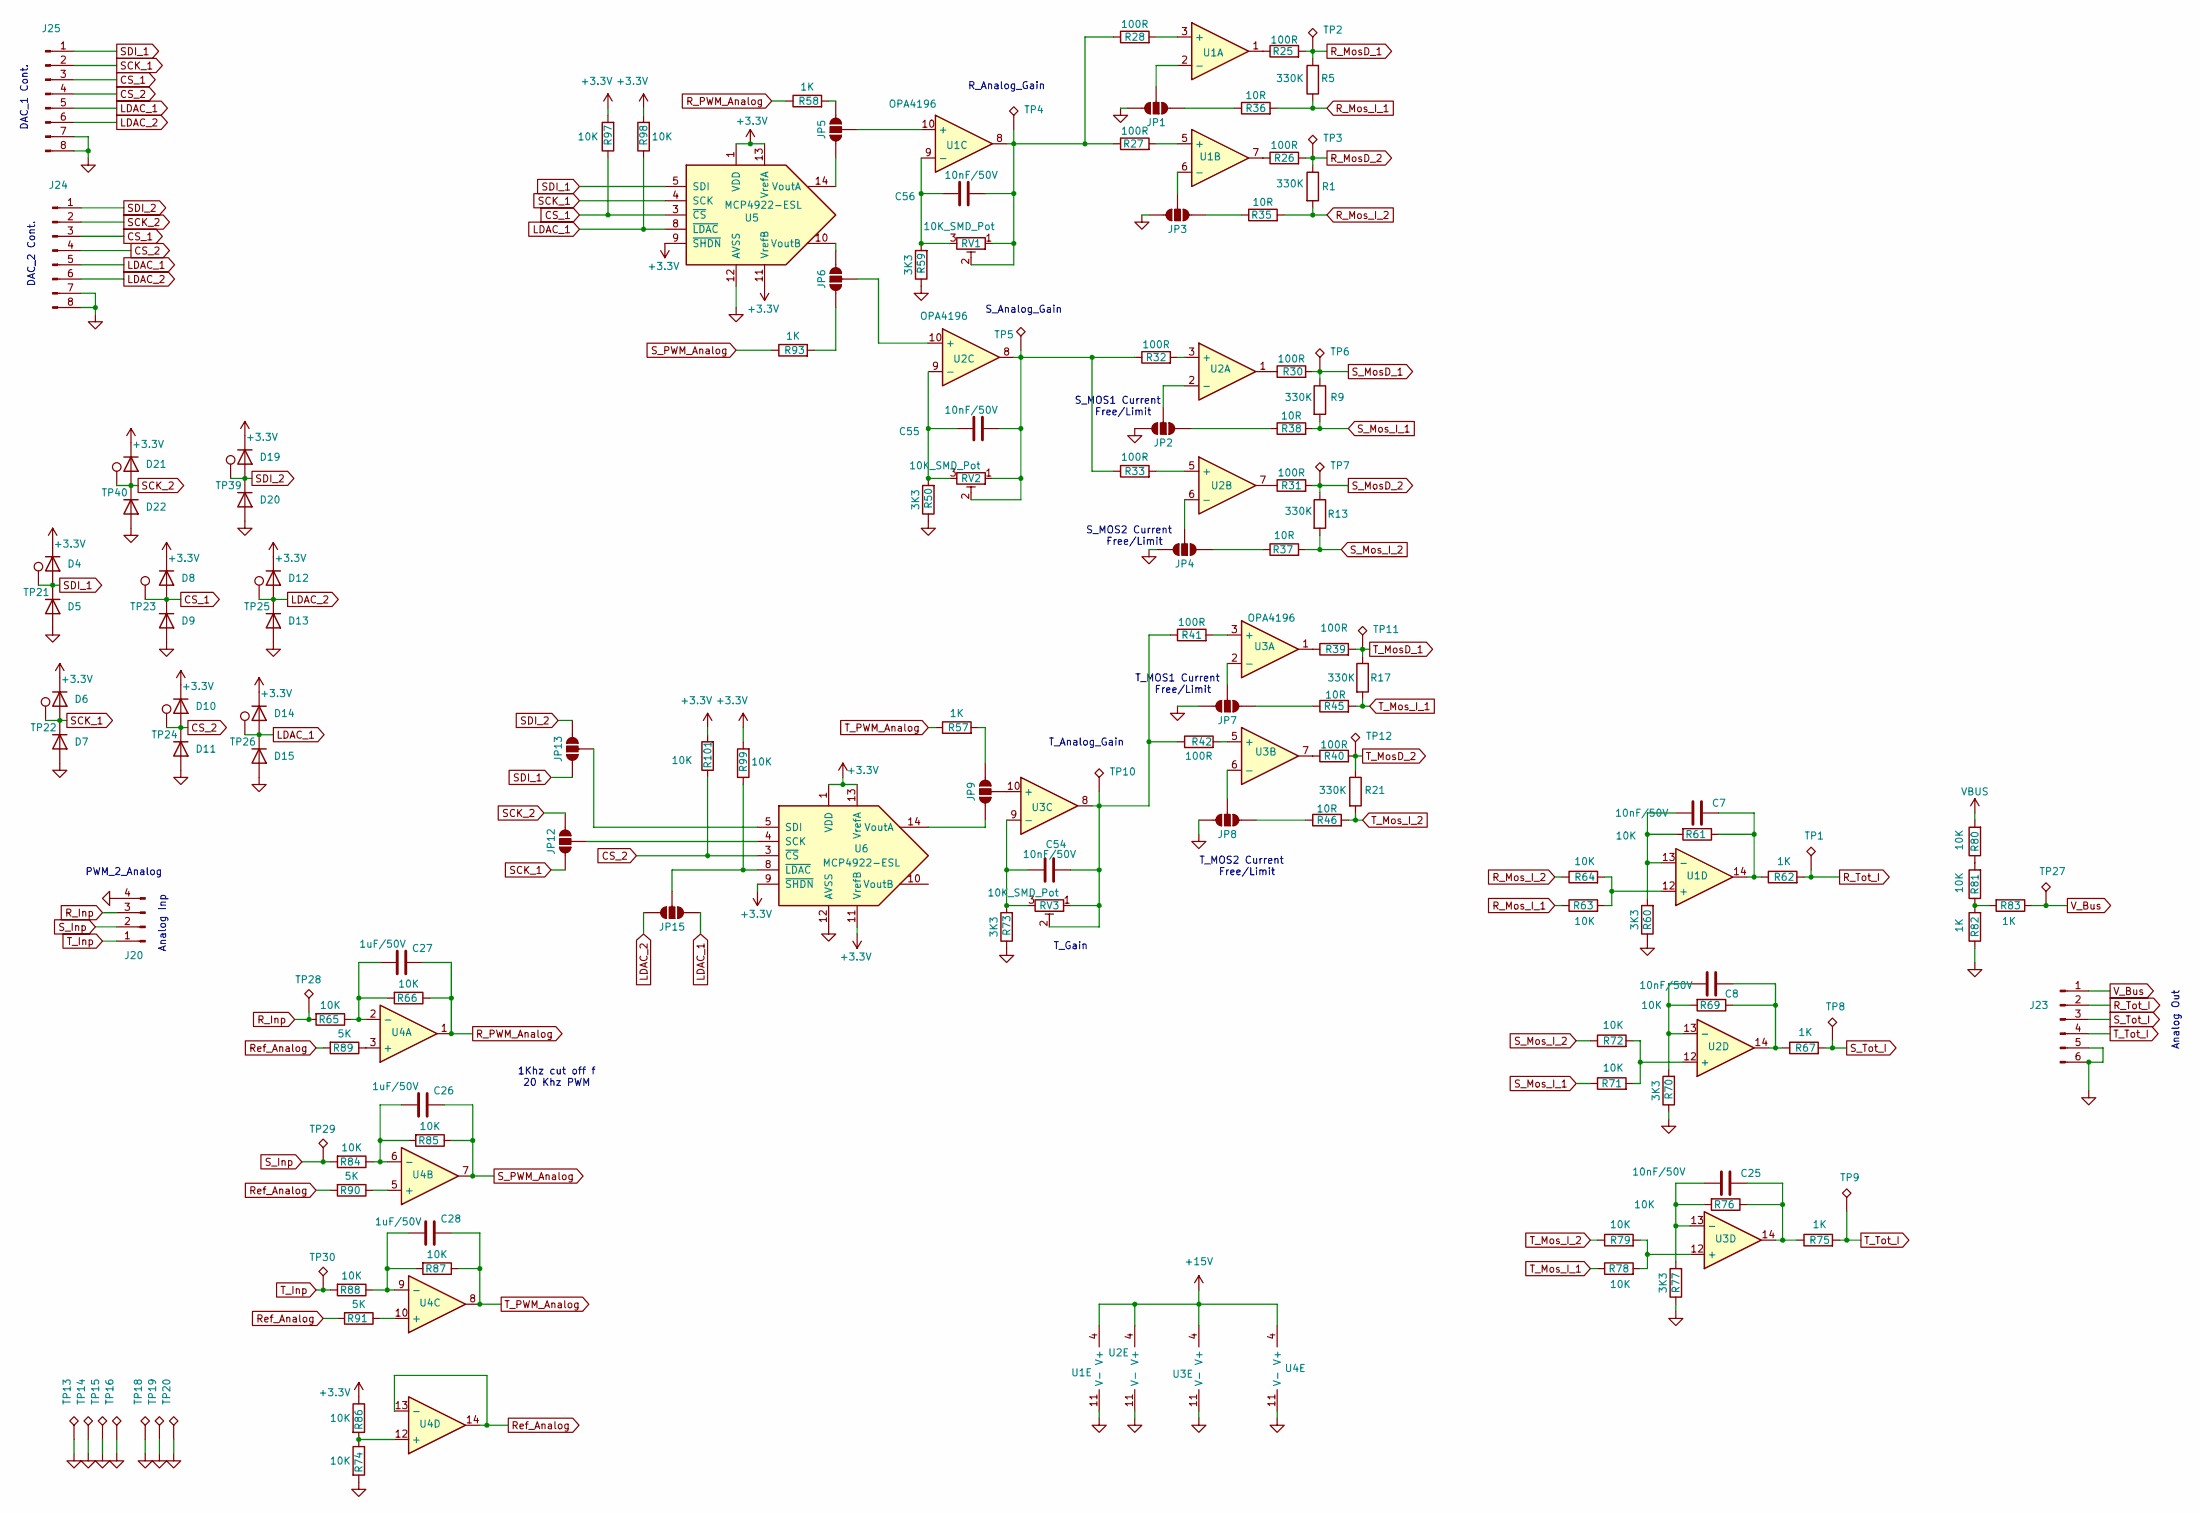
[picture p20: schematic Signals.kicad_sch, Emulator Current Generator]

Parts:
C7, C8, C25, C54, C55, C56: 10nF/50V; C_0805_2012Metric_Pad1.18x1.45mm_HandSolder
C26, C27, C28: 1uF/50V; C_1206_3216Metric_Pad1.33x1.80mm_HandSolder
D4, D5, D6, D7, D8, D9, D10, D11, D12, D13, D14, D15, D19, D20, D21, D22: US2AA; D_SMA
J20: Conn_01x04_Pin_JST_2.0mm; JST_PH_B4B-PH-K_1x04_P2.00mm_Vertical
J23: Conn_01x06_Pin_JST_2.0mm; JST_PH_B6B-PH-K_1x06_P2.00mm_Vertical
J24, J25: Conn_01x08_Pin_JST_2.0mm; JST_PH_B8B-PH-K_1x08_P2.00mm_Vertical
JP1, JP2, JP3, JP4, JP5, JP6, JP7, JP8, JP9, JP12, JP13, JP15: SolderJumper_3_Open; SolderJumper-3_P2.0mm_Open_TrianglePad1.0x1.5mm
R1, R5, R9, R13, R17, R21: 330K; R_Axial_DIN0207_L6.3mm_D2.5mm_P7.62mm_Horizontal
R25, R26, R27, R28, R30, R31, R32, R33, R39, R40, R41, R42: 100R; R_0805_2012Metric_Pad1.20x1.40mm_HandSolder
R35, R36, R37, R38, R45, R46: 10R; R_0805_2012Metric_Pad1.20x1.40mm_HandSolder
R50, R59, R60, R70, R73, R77: 3K3; R_0805_2012Metric_Pad1.20x1.40mm_HandSolder
R57, R58, R62, R67, R75, R82, R83, R93: 1K; R_0805_2012Metric_Pad1.20x1.40mm_HandSolder
R61, R63, R64, R65, R66, R69, R71, R72, R74, R76, R78, R79, R80, R81, R84, R85, R86, R87, R88, R97, R98, R99, R101: 10K; R_0805_2012Metric_Pad1.20x1.40mm_HandSolder
R89, R90, R91: 5K; R_0805_2012Metric_Pad1.20x1.40mm_HandSolder
RV1, RV2, RV3: 10K_SMD_Pot; Potentiometer_Bourns_3314J_Vertical
TP1, TP2, TP3, TP4, TP5, TP6, TP7, TP8, TP9, TP10, TP11, TP12, TP13, TP14, TP15, TP16, TP18, TP19, TP20, TP27, TP28, TP29, TP30: Test_Point_THT_KeyStone; TestPoint_Loop_D1.80mm_Drill1.0mm_Beaded
TP21, TP22, TP23, TP24, TP25, TP26, TP39, TP40: Test_Pad_Not_A_Component; TestPoint_Pad_D1.0mm
U1, U2, U3, U4: Opamp_Quad_OPA_4196; SOIC-14_3.9x8.7mm_P1.27mm
U5, U6: MCP4922-ESL; SOIC-14_3.9x8.7mm_P1.27mm

Connections:
+3.3V: D4.1 (K), D6.1 (K), D8.1 (K), D10.1 (K), D12.1 (K), D14.1 (K), D19.1 (K), D21.1 (K), R86.1, R97.2, R98.2, R99.2, R101.2, U5.1 (VDD), U5.9 (~SHDN), U5.11 (VrefB), U5.13 (VrefA), U6.1 (VDD), U6.9 (~SHDN), U6.11 (VrefB), U6.13 (VrefA); also elsewhere on the board
+15V: U1.4 (V+), U2.4 (V+), U3.4 (V+), U4.4 (V+); also elsewhere on the board
CS_1: D8.2 (A), D9.1 (K), J24.3, J25.3, R97.1, TP23.1, U5.3 (~CS)
CS_2: D10.2 (A), D11.1 (K), J24.4, J25.4, R101.1, TP24.1, U6.3 (~CS)
GND: D5.2 (A), D7.2 (A), D9.2 (A), D11.2 (A), D13.2 (A), D15.2 (A), D20.2 (A), D22.2 (A), J20.4, J23.5, J23.6, J24.7, J24.8, J25.7, J25.8, JP1.3 (B), JP2.3 (B), JP3.3 (B), JP4.3 (B), JP7.3 (B), JP8.3 (B), R50.1, R59.1, R60.1, R70.1, R73.1, R74.2, R77.1, R82.1, TP13.1, TP14.1, TP15.1, TP16.1, TP18.1, TP19.1, TP20.1, U1.11 (V-), U2.11 (V-), U3.11 (V-), U4.11 (V-), U5.12 (AVSS), U6.12 (AVSS); also elsewhere on the board
LDAC_1: D14.2 (A), D15.1 (K), J24.5, J25.5, JP15.1 (A), R98.1, TP26.1, U5.8 (~LDAC)
LDAC_2: D12.2 (A), D13.1 (K), J24.6, J25.6, JP15.3 (B), TP25.1
unnamed: C7.2, R61.1, R62.1, U1.14
unnamed: C8.2, R67.1, R69.1, U2.14
unnamed: C25.2, R75.1, R76.1, U3.14
unnamed: C54.2, R41.1, R42.1, RV3.1, RV3.2, TP10.1, U3.8
unnamed: C55.2, R32.1, R33.1, RV2.1, RV2.2, TP5.1, U2.8
unnamed: C56.2, R27.1, R28.1, RV1.1, RV1.2, TP4.1, U1.8
unnamed: JP1.1 (A), R36.1
unnamed: JP1.2 (C), U1.2 (-)
unnamed: JP2.1 (A), R38.1
unnamed: JP2.2 (C), U2.2 (-)
unnamed: JP3.1 (A), R35.1
unnamed: JP3.2 (C), U1.6 (-)
unnamed: JP4.1 (A), R37.1
unnamed: JP4.2 (C), U2.6 (-)
unnamed: JP5.1 (A), U5.14 (VoutA)
unnamed: JP5.3 (B), R58.2
unnamed: JP5.2 (C), U1.10 (+)
unnamed: JP6.1 (A), R93.2
unnamed: JP6.3 (B), U5.10 (VoutB)
unnamed: JP6.2 (C), U2.10 (+)
unnamed: JP7.1 (A), R45.1
unnamed: JP7.2 (C), U3.2 (-)
unnamed: JP8.1 (A), R46.1
unnamed: JP8.2 (C), U3.6 (-)
unnamed: JP9.1 (A), U6.14 (VoutA)
unnamed: JP9.3 (B), R57.2
unnamed: JP9.2 (C), U3.10 (+)
unnamed: JP12.2 (C), U6.4 (SCK)
unnamed: JP13.2 (C), U6.5 (SDI)
unnamed: JP15.2 (C), R99.1, U6.8 (~LDAC)
unnamed: R25.1, U1.1
unnamed: R26.1, U1.7
unnamed: R30.1, U2.1
unnamed: R31.1, U2.7
unnamed: R39.1, U3.1
unnamed: R40.1, U3.7
unnamed: R80.1, R81.2
unnamed: R81.1, R82.2, R83.2
unnamed: R28.2, U1.3 (+)
unnamed: R27.2, U1.5 (+)
unnamed: C56.1, R59.2, RV1.3, U1.9 (-)
unnamed: R63.2, R64.2, U1.12 (+)
unnamed: C7.1, R60.2, R61.2, U1.13 (-)
unnamed: R32.2, U2.3 (+)
unnamed: R33.2, U2.5 (+)
unnamed: C55.1, R50.2, RV2.3, U2.9 (-)
unnamed: R71.2, R72.2, U2.12 (+)
unnamed: C8.1, R69.2, R70.2, U2.13 (-)
unnamed: R41.2, U3.3 (+)
unnamed: R42.2, U3.5 (+)
unnamed: C54.1, R73.2, RV3.3, U3.9 (-)
unnamed: R78.2, R79.2, U3.12 (+)
unnamed: C25.1, R76.2, R77.2, U3.13 (-)
unnamed: R89.1, U4.3 (+)
unnamed: C27.1, R65.1, R66.2, U4.2 (-)
unnamed: R90.1, U4.5 (+)
unnamed: C26.1, R84.1, R85.2, U4.6 (-)
unnamed: R91.1, U4.10 (+)
unnamed: C28.1, R87.2, R88.1, U4.9 (-)
unnamed: R74.1, R86.2, U4.12 (+)
R_Inp: J20.3, R65.2, TP28.1
R_MosD_1: R5.2, R25.2, TP2.1; also elsewhere on the board
R_MosD_2: R1.1, R26.2, TP3.1; also elsewhere on the board
R_Mos_I_1: R5.1, R36.2, R63.1; also elsewhere on the board
R_Mos_I_2: R1.2, R35.2, R64.1; also elsewhere on the board
R_PWM_Analog: C27.2, R58.1, R66.1, U4.1
R_Tot_I: J23.2, R62.2, TP1.1
Ref_Analog: R89.2, R90.2, R91.2, U4.13 (-), U4.14
SCK_1: D6.2 (A), D7.1 (K), J25.2, JP12.1 (A), TP22.1, U5.4 (SCK)
SCK_2: D21.2 (A), D22.1 (K), J24.2, JP12.3 (B), TP40.1
SDI_1: D4.2 (A), D5.1 (K), J25.1, JP13.1 (A), TP21.1, U5.5 (SDI)
SDI_2: D19.2 (A), D20.1 (K), J24.1, JP13.3 (B), TP39.1
S_Inp: J20.2, R84.2, TP29.1
S_MosD_1: R9.1, R30.2, TP6.1; also elsewhere on the board
S_MosD_2: R13.1, R31.2, TP7.1; also elsewhere on the board
S_Mos_I_1: R9.2, R38.2, R71.1; also elsewhere on the board
S_Mos_I_2: R13.2, R37.2, R72.1; also elsewhere on the board
S_PWM_Analog: C26.2, R85.1, R93.1, U4.7
S_Tot_I: J23.3, R67.2, TP8.1
T_Inp: J20.1, R88.2, TP30.1
T_MosD_1: R17.1, R39.2, TP11.1; also elsewhere on the board
T_MosD_2: R21.1, R40.2, TP12.1; also elsewhere on the board
T_Mos_I_1: R17.2, R45.2, R78.1; also elsewhere on the board
T_Mos_I_2: R21.2, R46.2, R79.1; also elsewhere on the board
T_PWM_Analog: C28.2, R57.1, R87.1, U4.8
T_Tot_I: J23.4, R75.2, TP9.1
VBUS: R80.2; also elsewhere on the board
V_Bus: J23.1, R83.1, TP27.1

Notes on the sheet:
S_MOS1 Current Free/Limit
PWM_2_Analog
Analog Out
1Khz cut off f 20 Khz PWM
R_Analog_Gain
T_MOS1 Current Free/Limit
S_Analog_Gain
T_MOS2 Current Free/Limit
T_Analog_Gain
S_MOS2 Current Free/Limit
DAC_1 Cont.
Analog Inp
T_Gain
DAC_2 Cont.
