ilkerya/Emulator_PCB/Cur_Emul/Cur_Emul.kicad_pcb

## KiCad design Cur_Emul/Cur_Emul.kicad_pcb (continued)

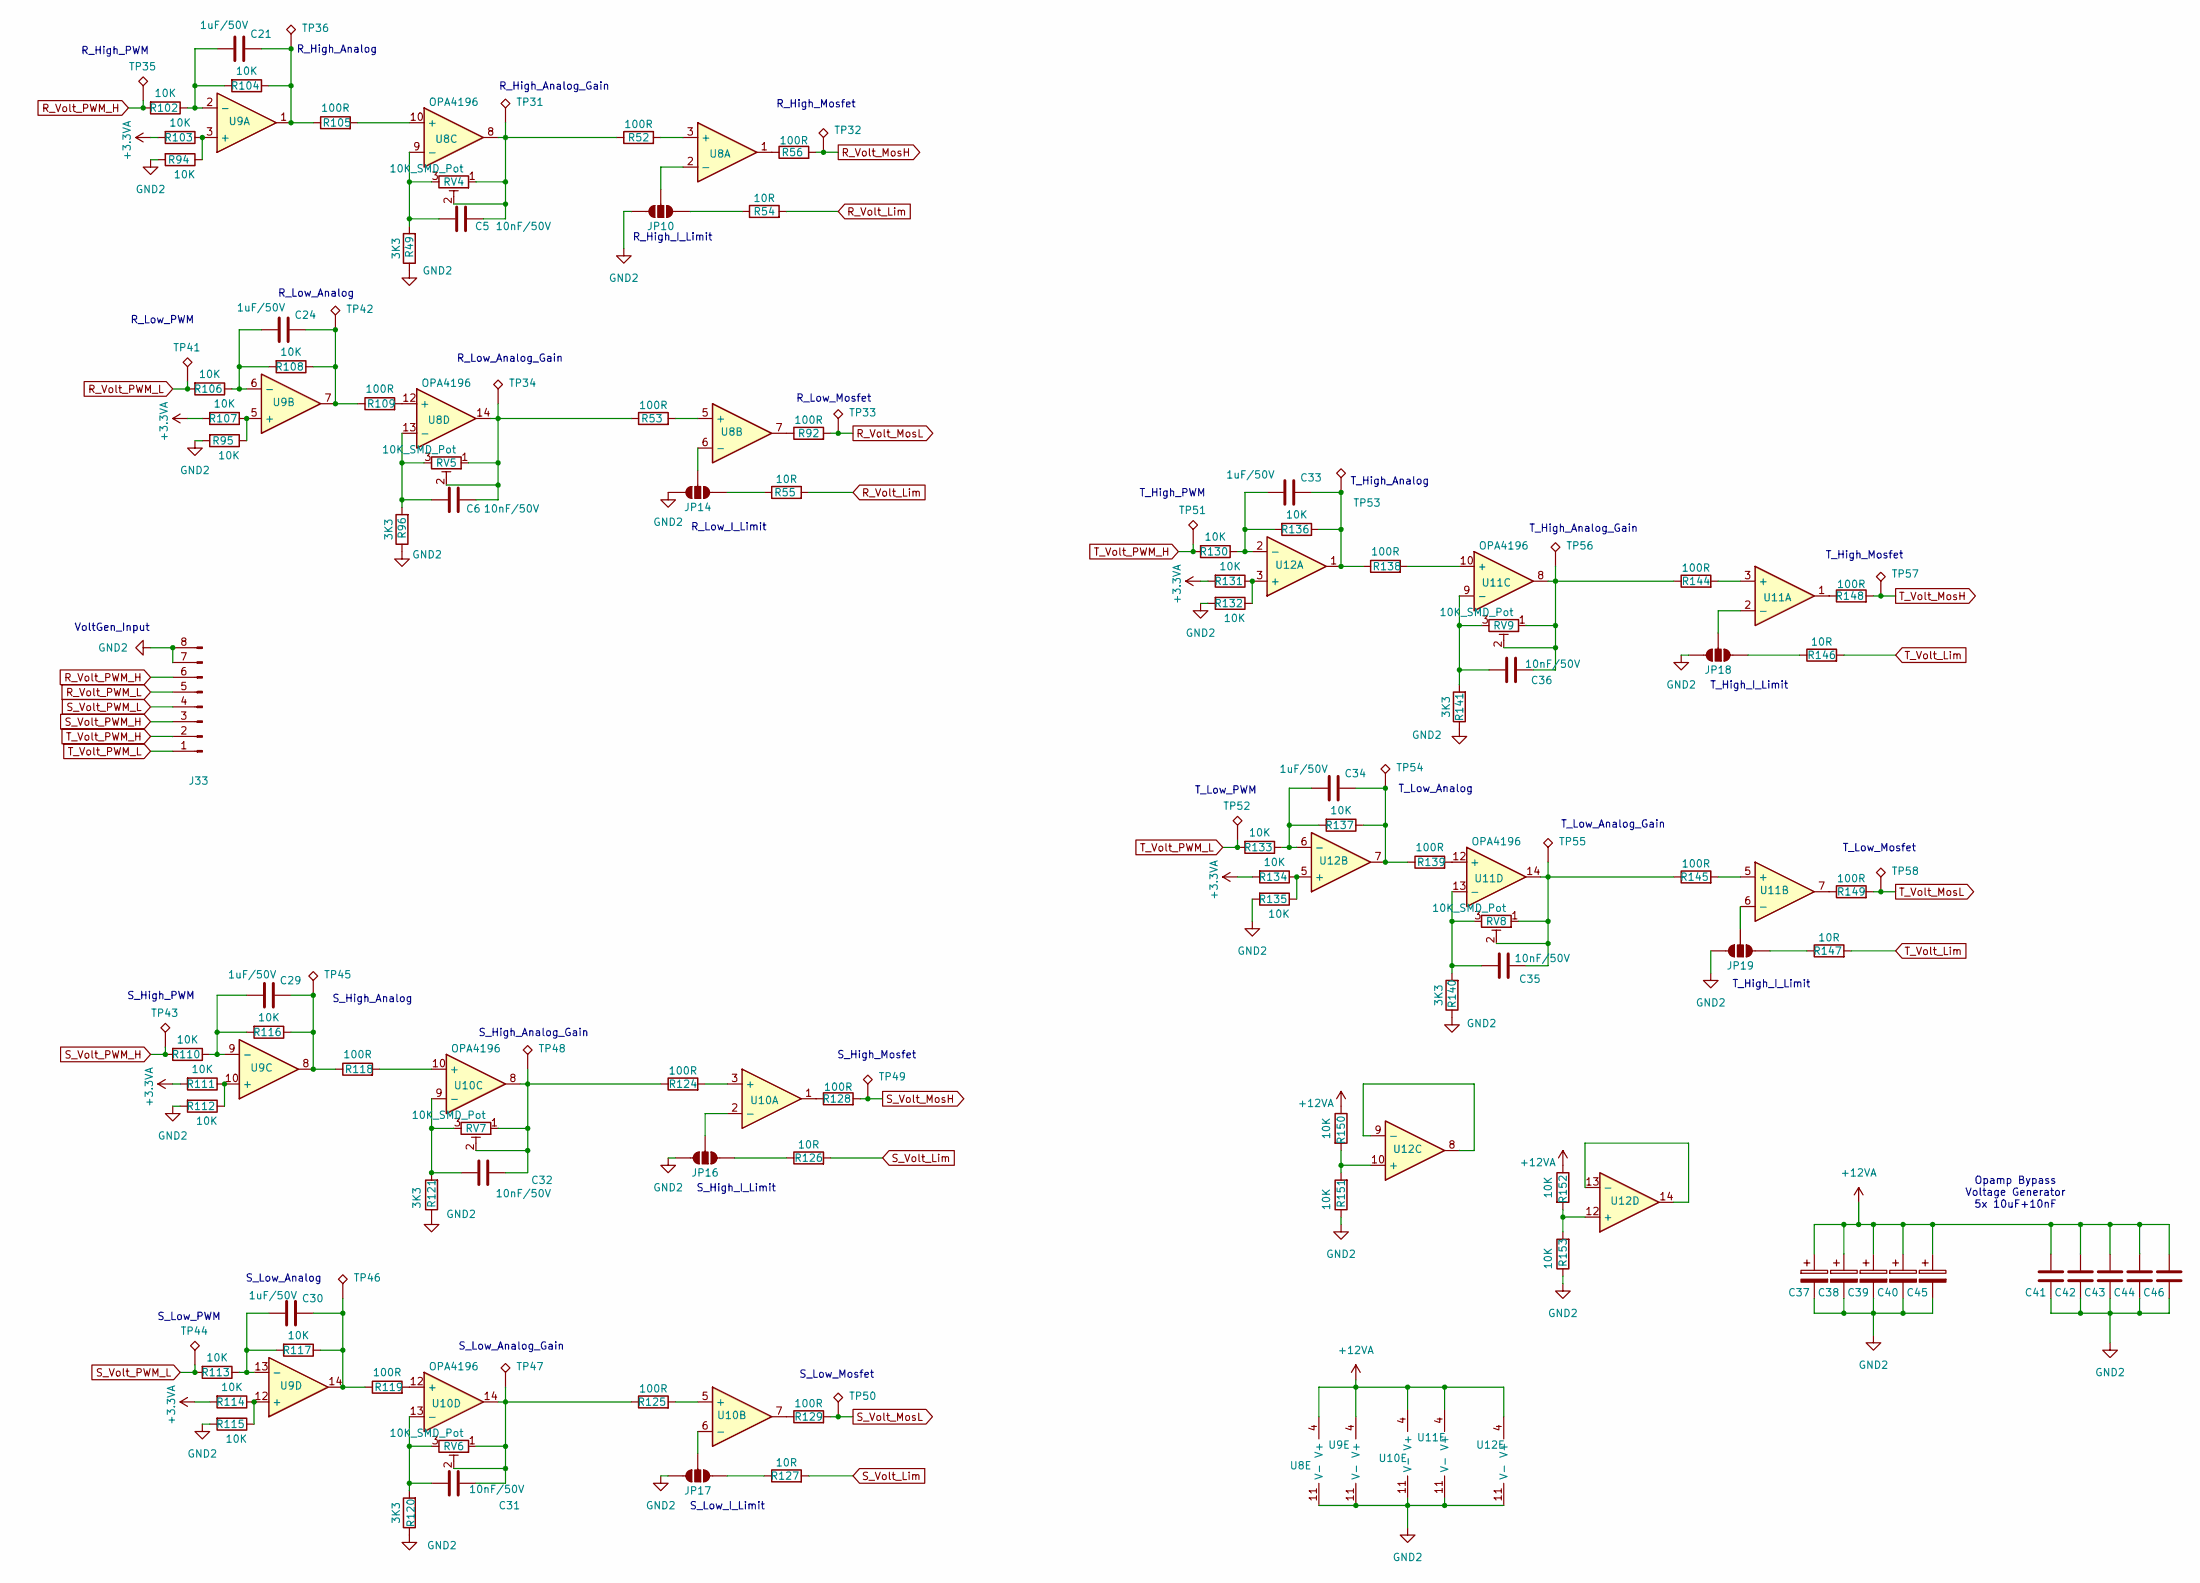
[picture p21: schematic Volt_Gen.kicad_sch, Emulator Voltage Generator]

Parts:
C5, C6, C31, C32, C35, C36, C41, C42, C43, C44, C46: 10nF/50V; C_0805_2012Metric_Pad1.18x1.45mm_HandSolder
C21, C24, C29, C30, C33, C34: 1uF/50V; C_1206_3216Metric_Pad1.33x1.80mm_HandSolder
C37, C38, C39, C40, C45: 10uF/50V; CP_Elec_4x3.9
J33: Conn_01x08_Pin_JST_2.0mm; JST_PH_B8B-PH-K_1x08_P2.00mm_Vertical
JP10, JP14, JP16, JP17, JP18, JP19: SolderJumper_3_Open; SolderJumper-3_P2.0mm_Open_TrianglePad1.0x1.5mm
R49, R96, R120, R121, R140, R141: 3K3; R_0805_2012Metric_Pad1.20x1.40mm_HandSolder
R52, R53, R56, R92, R105, R109, R118, R119, R124, R125, R128, R129, R138, R139, R144, R145, R148, R149: 100R; R_0805_2012Metric_Pad1.20x1.40mm_HandSolder
R54, R55, R126, R127, R146, R147: 10R; R_0805_2012Metric_Pad1.20x1.40mm_HandSolder
R94, R95, R102, R103, R104, R106, R107, R108, R110, R111, R112, R113, R114, R115, R116, R117, R130, R131, R132, R133, R134, R135, R136, R137, R150, R151, R152, R153: 10K; R_0805_2012Metric_Pad1.20x1.40mm_HandSolder
RV4, RV5, RV6, RV7, RV8, RV9: 10K_SMD_Pot; Potentiometer_Bourns_3314J_Vertical
TP31, TP32, TP33, TP34, TP35, TP36, TP41, TP42, TP43, TP44, TP45, TP46, TP47, TP48, TP49, TP50, TP51, TP52, TP53, TP54, TP55, TP56, TP57, TP58: Test_Point_THT_KeyStone; TestPoint_Loop_D1.80mm_Drill1.0mm_Beaded
U8, U9, U10, U11, U12: Opamp_Quad_OPA_4196; SOIC-14_3.9x8.7mm_P1.27mm

Connections:
+3.3VA: R103.2, R107.2, R111.2, R114.2, R131.2, R134.2; also elsewhere on the board
+12VA: C37.1, C38.1, C39.1, C40.1, C41.1, C42.1, C43.1, C44.1, C45.1, C46.1, R150.1, R152.1, U8.4 (V+), U9.4 (V+), U10.4 (V+), U11.4 (V+), U12.4 (V+); also elsewhere on the board
GND2: C37.2, C38.2, C39.2, C40.2, C41.2, C42.2, C43.2, C44.2, C45.2, C46.2, J33.7, J33.8, JP10.3 (B), JP14.3 (B), JP16.3 (B), JP17.3 (B), JP18.3 (B), JP19.3 (B), R49.1, R94.2, R95.2, R96.1, R112.2, R115.2, R120.1, R121.1, R132.2, R135.2, R140.1, R141.1, R151.1, R153.1, U8.11 (V-), U9.11 (V-), U10.11 (V-), U11.11 (V-), U12.11 (V-); also elsewhere on the board
unnamed: C5.2, R52.1, RV4.1, RV4.2, TP31.1, U8.8
unnamed: C6.2, R53.1, RV5.1, RV5.2, TP34.1, U8.14
unnamed: C21.2, R104.1, R105.1, TP36.1, U9.1
unnamed: C24.2, R108.1, R109.1, TP42.1, U9.7
unnamed: C29.2, R116.1, R118.1, TP45.1, U9.8
unnamed: C30.2, R117.1, R119.1, TP46.1, U9.14
unnamed: C31.2, R125.1, RV6.1, RV6.2, TP47.1, U10.14
unnamed: C32.2, R124.1, RV7.1, RV7.2, TP48.1, U10.8
unnamed: C33.2, R136.1, R138.1, TP53.1, U12.1
unnamed: C34.2, R137.1, R139.1, TP54.1, U12.7
unnamed: C35.2, R145.1, RV8.1, RV8.2, TP55.1, U11.14
unnamed: C36.2, R144.1, RV9.1, RV9.2, TP56.1, U11.8
unnamed: JP10.1 (A), R54.1
unnamed: JP10.2 (C), U8.2 (-)
unnamed: JP14.1 (A), R55.1
unnamed: JP14.2 (C), U8.6 (-)
unnamed: JP16.1 (A), R126.1
unnamed: JP16.2 (C), U10.2 (-)
unnamed: JP17.1 (A), R127.1
unnamed: JP17.2 (C), U10.6 (-)
unnamed: JP18.1 (A), R146.1
unnamed: JP18.2 (C), U11.2 (-)
unnamed: JP19.1 (A), R147.1
unnamed: JP19.2 (C), U11.6 (-)
unnamed: R56.1, U8.1
unnamed: R92.1, U8.7
unnamed: R128.1, U10.1
unnamed: R129.1, U10.7
unnamed: R148.1, U11.1
unnamed: R149.1, U11.7
unnamed: R52.2, U8.3 (+)
unnamed: R53.2, U8.5 (+)
unnamed: R105.2, U8.10 (+)
unnamed: C5.1, R49.2, RV4.3, U8.9 (-)
unnamed: R109.2, U8.12 (+)
unnamed: C6.1, R96.2, RV5.3, U8.13 (-)
unnamed: R94.1, R103.1, U9.3 (+)
unnamed: C21.1, R102.1, R104.2, U9.2 (-)
unnamed: R95.1, R107.1, U9.5 (+)
unnamed: C24.1, R106.1, R108.2, U9.6 (-)
unnamed: R111.1, R112.1, U9.10 (+)
unnamed: C29.1, R110.1, R116.2, U9.9 (-)
unnamed: R114.1, R115.1, U9.12 (+)
unnamed: C30.1, R113.1, R117.2, U9.13 (-)
unnamed: R124.2, U10.3 (+)
unnamed: R125.2, U10.5 (+)
unnamed: R118.2, U10.10 (+)
unnamed: C32.1, R121.2, RV7.3, U10.9 (-)
unnamed: R119.2, U10.12 (+)
unnamed: C31.1, R120.2, RV6.3, U10.13 (-)
unnamed: R144.2, U11.3 (+)
unnamed: R145.2, U11.5 (+)
unnamed: R138.2, U11.10 (+)
unnamed: C36.1, R141.2, RV9.3, U11.9 (-)
unnamed: R139.2, U11.12 (+)
unnamed: C35.1, R140.2, RV8.3, U11.13 (-)
unnamed: R131.1, R132.1, U12.3 (+)
unnamed: C33.1, R130.1, R136.2, U12.2 (-)
unnamed: R134.1, R135.1, U12.5 (+)
unnamed: C34.1, R133.1, R137.2, U12.6 (-)
unnamed: R150.2, R151.2, U12.10 (+)
unnamed: U12.8, U12.9 (-)
unnamed: R152.2, R153.2, U12.12 (+)
unnamed: U12.13 (-), U12.14
R_Volt_Lim: R54.2, R55.2; also elsewhere on the board
R_Volt_MosH: R56.2, TP32.1; also elsewhere on the board
R_Volt_MosL: R92.2, TP33.1; also elsewhere on the board
R_Volt_PWM_H: J33.6, R102.2, TP35.1
R_Volt_PWM_L: J33.5, R106.2, TP41.1
S_Volt_Lim: R126.2, R127.2; also elsewhere on the board
S_Volt_MosH: R128.2, TP49.1; also elsewhere on the board
S_Volt_MosL: R129.2, TP50.1; also elsewhere on the board
S_Volt_PWM_H: J33.3, R110.2, TP43.1
S_Volt_PWM_L: J33.4, R113.2, TP44.1
T_Volt_Lim: R146.2, R147.2; also elsewhere on the board
T_Volt_MosH: R148.2, TP57.1; also elsewhere on the board
T_Volt_MosL: R149.2, TP58.1; also elsewhere on the board
T_Volt_PWM_H: J33.2, R130.2, TP51.1
T_Volt_PWM_L: J33.1, R133.2, TP52.1

Notes on the sheet:
S_Low_Analog_Gain
S_High_I_Limit
R_Low_PWM
S_High_Analog_Gain
S_Low_PWM
T_Low_Analog
R_Low_Analog
R_Low_I_Limit
R_Low_Analog_Gain
T_Low_PWM
T_Low_Analog_Gain
S_High_Mosfet
S_Low_Analog
S_Low_I_Limit
S_Low_Mosfet
R_High_I_Limit
R_High_Analog
T_High_Mosfet
R_High_PWM
S_High_PWM
T_Low_Mosfet
T_High_I_Limit
T_High_Analog
T_High_PWM
Opamp Bypass Voltage Generator 5x 10uF+10nF
T_High_Analog_Gain
R_Low_Mosfet
S_High_Analog
VoltGen_Input
R_High_Mosfet
R_High_Analog_Gain

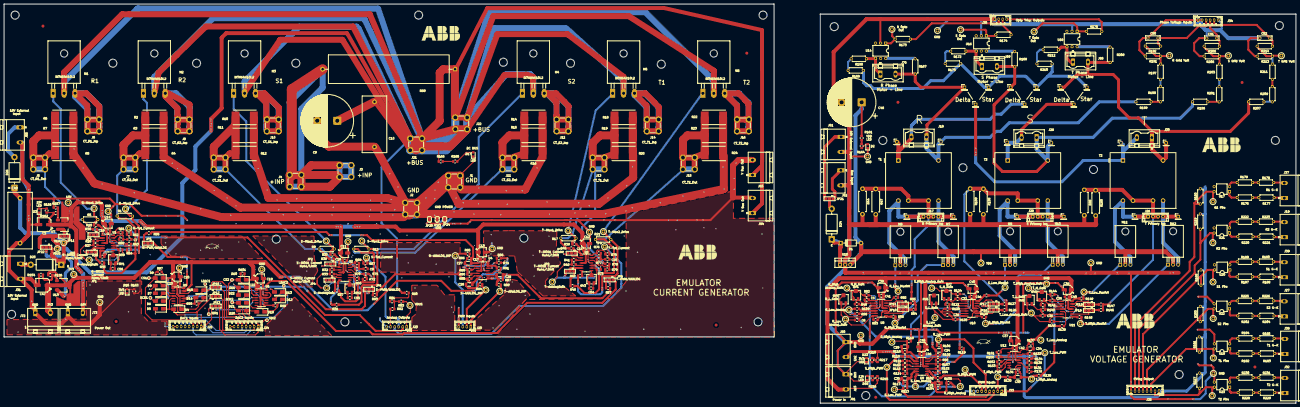
[picture p22: board Cur_Emul.kicad_pcb from above]

Board: 2 copper layers, 644.3 x 199.1 mm, 525 parts (0 on the bottom side), 289 nets.

Other parts of the board:
C9: 300uF/50V; CP_Radial_D26.0mm_P10.00mm_SnapIn
C10: 1uF/50V MKT; C_Rect_L28.0mm_W12.0mm_P22.50mm_MKS4
Fiducial: Fiducial_1.5mm_Mask3mm
Fiducial#2, Fiducial#3, Fiducial#4, Fiducial#5, Fiducial#6, Fiducial#7, Fiducial#8: Fiducial_1.5mm_Mask3mm
J1, J2, J3, J4, J5, J6, J7, J8, J9, J10, J11, J12, J13, J14, J15, J16, J21, J22: Wuerth_REDCUBE-74651175_ScrewTerminal; Wuerth_REDCUBE-THR_WP-THRSH_74651175_THR
JP20, JP23, JP24: SolderJumper_2_Bridged; SolderJumper-2_P1.3mm_Bridged2Bar_RoundedPad1.0x1.5mm
M1, M2, M3, M4, M5, M6: IXTH64N10L2; TO-247-3_Horizontal_TabDown
M7, M8, M9, M10, M11, M12: IRF530; TO-220-3_Horizontal_TabDown
R2, R3, R4, R6, R7, R8, R10, R11, R12, R14, R15, R16, R18, R19, R20, R22, R23, R24: 10mOhm_Vishay_WSR3_Shunt; R_Shunt_Vishay_WSR2_WSR3
R44, R47, R48, R158, R159, R160: 4R7/2W; R_Axial_DIN0411_L9.9mm_D3.6mm_P12.70mm_Horizontal
R68: 1R/100W; R_Axial_Power_L60.0mm_W14.0mm_P66.04mm
T1, T2, T3: Transformer_1P_2S; Transformer_Myrra_EI30-5_44000_Horizontal

Their connections:
GND: JP20.2 (B), JP23.2 (B), JP24.2 (B); also elsewhere on the board
GND2: R44.2, R47.2, R48.2, R158.2, R159.2, R160.2; also elsewhere on the board
GNDPWR: C9.2, C10.2, J1.1, J2.1, JP20.1 (A), JP23.1 (A), JP24.1 (A), R2.2, R3.2, R4.2, R6.2, R7.2, R8.2, R10.2, R11.2, R12.2, R14.2, R15.2, R16.2, R18.2, R19.2, R20.2, R22.2, R23.2, R24.2; also elsewhere on the board
unnamed: J3.1, J4.1, R68.1
unnamed: J6.1, M1.3 (S)
unnamed: J8.1, M2.3 (S)
unnamed: J10.1, M3.3 (S)
unnamed: J12.1, M4.3 (S)
unnamed: J14.1, M5.3 (S)
unnamed: J16.1, M6.3 (S)
R_MosD_1: M1.1 (G); also elsewhere on the board
R_MosD_2: M2.1 (G); also elsewhere on the board
R_Mos_I_1: J5.1, R6.1, R7.1, R8.1; also elsewhere on the board
R_Mos_I_2: J7.1, R2.1, R3.1, R4.1; also elsewhere on the board
R_Prim_H: M7.3 (S), T1.6 (SA); also elsewhere on the board
R_Prim_L: M8.3 (S), T1.10 (SD); also elsewhere on the board
R_Sec_a: T1.1 (AA); also elsewhere on the board
R_Sec_b: T1.5 (AB); also elsewhere on the board
R_Volt_Lim: R44.1, R47.1, T1.7 (SB), T1.9 (SC); also elsewhere on the board
R_Volt_MosH: M7.1 (G); also elsewhere on the board
R_Volt_MosL: M8.1 (G); also elsewhere on the board
S_MosD_1: M3.1 (G); also elsewhere on the board
S_MosD_2: M4.1 (G); also elsewhere on the board
S_Mos_I_1: J9.1, R10.1, R11.1, R12.1; also elsewhere on the board
S_Mos_I_2: J11.1, R14.1, R15.1, R16.1; also elsewhere on the board
S_Prim_H: M10.3 (S), T3.6 (SA); also elsewhere on the board
S_Prim_L: M9.3 (S), T3.10 (SD); also elsewhere on the board
S_Sec_a: T3.1 (AA); also elsewhere on the board
S_Sec_b: T3.5 (AB); also elsewhere on the board
S_Volt_Lim: R158.1, R159.1, T3.7 (SB), T3.9 (SC); also elsewhere on the board
S_Volt_MosH: M10.1 (G); also elsewhere on the board
S_Volt_MosL: M9.1 (G); also elsewhere on the board
T_MosD_1: M5.1 (G); also elsewhere on the board
T_MosD_2: M6.1 (G); also elsewhere on the board
T_Mos_I_1: J13.1, R18.1, R19.1, R20.1; also elsewhere on the board
T_Mos_I_2: J15.1, R22.1, R23.1, R24.1; also elsewhere on the board
T_Prim_H: M12.3 (S), T2.6 (SA); also elsewhere on the board
T_Prim_L: M11.3 (S), T2.10 (SD); also elsewhere on the board
T_Sec_a: T2.1 (AA); also elsewhere on the board
T_Sec_b: T2.5 (AB); also elsewhere on the board
T_Volt_Lim: R48.1, R160.1, T2.7 (SB), T2.9 (SC); also elsewhere on the board
T_Volt_MosH: M12.1 (G); also elsewhere on the board
T_Volt_MosL: M11.1 (G); also elsewhere on the board
VBUS: C9.1, C10.1, J21.1, J22.1, M1.2 (D), M2.2 (D), M3.2 (D), M4.2 (D), M5.2 (D), M6.2 (D), R68.2; also elsewhere on the board
VDD: M7.2 (D), M8.2 (D), M9.2 (D), M10.2 (D), M11.2 (D), M12.2 (D); also elsewhere on the board
