ilkerya/Emulator_PCB/Tabel Layout/Tabel Layout.kicad_pcb

## KiCad design Tabel Layout/Tabel Layout.kicad_pcb (2025-09-16)

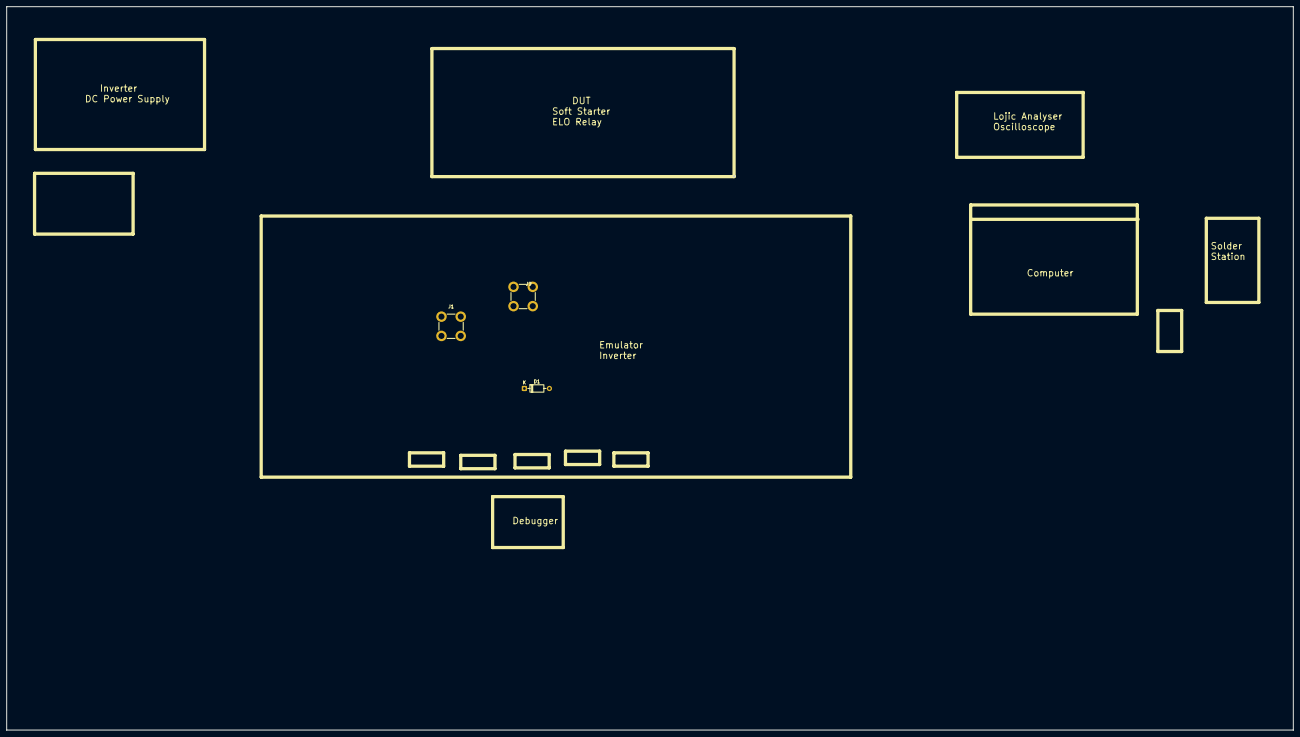
[picture p23: board Tabel Layout.kicad_pcb from above]

Board: 2 copper layers, 391.8 x 220.2 mm, 3 parts (0 on the bottom side), 2 nets, no tracks yet.

Parts:
D1: 1N914; D_DO-35_SOD27_P7.62mm_Horizontal
J1, J9: Screw_Terminal_01x01; Wuerth_REDCUBE-THR_WP-THRSH_74651175_THR

Connections:
GND: D1.2 (A), J9.1
try: D1.1 (K), J1.1
