ilkerya/Emulator_PCB/(commit log)

2025-09-25 pdf updates
    [Cur_Emul.kicad_pcb]
2025-10-06 with Fabr. Outputs
    [Cur_Emul-B_Cu.gbr, Cur_Emul-B_Mask.gbr, Cur_Emul-B_Paste.gbr, Cur_Emul-B_Silkscreen.gbr, Cur_Emul-Edge_Cuts.gbr, Cur_Emul-F_Cu.gbr, Cur_Emul-F_Mask.gbr, Cur_Emul-F_Paste.gbr]
2025-10-10 Sch issue Fix
    [Cur_Emul.kicad_sch]
